Domoconnor/orange-corpus/README.markdown

# orange-corpus
 
To create a new version of final.md run this command in your cloned version:

`cat *.md  > final.md`

Make sure there isn't a file called final.md when you run that command otherwise it will endlessly loop

After that open up final.md in macdown and export it as an html file.
