Domoconnor/orange-corpus/11_Minutes.md

### Minutes

Below are the minutes taken for every meeting that we, personally had between us as a group. They are a rough summary of what decisions we chose to take and how we followed up on them in the weeks after.

Weekly Minutes (September 27th - 25th March 2016)

####27/9/2015
##### Members attendance
* Daniel Andrews
* Dominic O’Connor
* Jack McBride
* Matthew Aldridge

##### Main points
* Project begins.
* Meeting with supervisor, arranging a meeting with clients.
* Research into general hardware understanding.
* Research into general electronics understanding.

##### Work Achieved previous week
* Orange Street itself documented, photographs taken of popular outlets along the street and general overview.

####3/10/2015
##### Members attendance
* Daniel Andrews
* Dominic O’Connor
* Jack McBride
* Matthew Aldridge

##### Main points
* Research into sensor amplifier, this is required for our sensor to accurately measure noise.
* Reading Portigal Book, this is required to interview our clients in the best format possible.

##### Work Achieved previous week
* Circuit diagrams for amplifier and research completed.
* Research into hardware boards completed.

####10/10/2015
##### Members attendance
* Daniel Andrews
* Dominic O’Connor
* Jack McBride

##### Main points
* Working on sensor amplifier, have to calculate accurate values for use.
* Concluding on client meetings, taking notes from the important moments in the meeting.
* Sensors are required as expected, multiple of them will be used to gather data on sound.
* Starting to learn 3D print, will need case designs for components in the project. 
* Start researching potential solutions in system architecture to the problem.

##### Work Achieved previous week
* Client interviews completed, recorded and documented. 

####18/10/2015
##### Members attendance
* Daniel Andrews
* Dominic O’Connor
* Jack McBride
* Matthew Aldridge

##### Main points
* A Basic sensor has been created using the amplifier circuit, can now use this act as a sensor temporarily.
* Program needs to be written to sample sound from the current sensor.
* Researching sound waves and understanding of sampling, need a better technical understanding of sampling sound waves and sound in general.
* Researching into potential networking solutions, we need a way of transferring this data from the sensor to the website.
* Researching into hardware boards, Arduinos, MBEDs, any particular board that could be used to handle the sensors requirements.

##### Work Achieved previous week
* Microphone amplifier built, testing begins this week.
* System architecture researched, deciding to use - sensor to hub to webserver.
* 3D print attempts, not successful for the board - but very close.
* Contacted council and received advice for legal standing on our project.

####25/10/2015
##### Members attendance
* Dominic O’Connor
* Jack McBride
* Matthew Aldridge

##### Main points
* Using the written program for sampling data from the sensor, taking this sampled data and working out how to gather the values we need in order to demonstrate a sound level.
* Using the FRDM K64F as a guide - 3D printing a case for this board.
* Decision to use the XBee as our networking module, offers great customisation and low power cost.

##### Work Achieved previous week
* Created program to sample sound waves, tested on Arduino and FRDM-K64F boards.
* First successful 3D printed case designed

####2/11/2015
##### Members attendance
* Daniel Andrews
* Dominic O’Connor
* Jack McBride
* Matthew Aldridge

##### Main points
* Started using Github to handle different elements of the project code base.
* Started getting XBees S2 talking to each other, sending dummy data between two modules.
* Began discussing how often we wish to sample data, how many samples to take and the accuracy of our data. 
* Researching into very low boards to act in place of the sensor.

##### Work Achieved previous week
* Displaying sound a period of time, research needed on decibels.
* Plenty of test data stored from the initial testing of sensor.
* Research completed on networking solutions.
* Website API implemented, sensor iteration 4 started by Dominic.

####9/11/2015
##### Members attendance
* Daniel Andrews
* Jack McBride
* Matthew Aldridge

##### Main points
* Discussed the potential of using the FRDM-K64F as a Hub as we are familiar with it.
* Looking into XBees and their configurability, discussing whether encryption or the alike is necessary.
* Researching into converting sound values into decibel levels.

##### Work Achieved previous week
* Using XBees to communicate over serial on FRDM-K64F with MBED application shields with AT mode.
* Concluded to sample data once a minute for 3 seconds, 60 times an hour.
* Multiple case designs printed.

####16/11/2015
##### Members attendance
* Daniel Andrews
* Dominic O’Connor
* Jack McBride
* Matthew Aldridge

##### Main points
* Still working with XBees, looking into setting up multiple on a network with a mesh topology as opposed to point to point.
* Discussed the battery concerns, clients ideally want a rechargeable set of batteries. Looking into battery solutions.
* Sketching visualisation ideas.  
* Decided on using the Rocket scream board for the sensor, but going to use Arduino Uno for the time being.

##### Work Achieved previous week
* Decided to use the FRDM-K64F as the Hub
* Successfully found a way to convert raw values from the sensor into decibels.
* Looked into configuring XBee modules.
* Sensor implemented clock for timestamping.

####23/11/2015
##### Members attendance
* Daniel Andrews
* Dominic O’Connor
* Matthew Aldridge

##### Main points
* Attempting to get an Arduino board communicating to an XBee, wiring the module up ourselves as it’s likely we’ll use an Arduino board.
* After showing 5 sketches produced from each other, we concepted some form of clock that displays noise levels.
* Researching into different solutions for a Hub instead of FRDM-K64F. 
* Prototype of sensor is going to be placed in client's house over Christmas break.
* Prototype will use local SD card instead of network due to power restrictions with the board being used.

##### Work Achieved previous week
* Researched batteries, worked out calculations required for the sensor in its current state to function over Christmas.
* Concepted the idea of a ‘clock’ from 5 sketches idea.
* Rocket Scream ordered, waiting for arrival.

####30/11/2015
##### Members attendance
* Daniel Andrews
* Dominic O’Connor
* Jack McBride
* Matthew Aldridge

##### Main points
* Mapping locations for sensors, where are we likely place them - what sort of problems does this raise?
* Concepting case designs for the Arduino Uno.
* Researching components for a clock like device.
* Working towards placing a sensor in client's house before Christmas.

##### Work Achieved previous week
* Arduino board communicating with XBee and an FRDM-K64F over serial using AT mode.
* Sensor SD card implemented, data will be stored locally for the project due

####7/12/2015
##### Members attendance
* Daniel Andrews
* Dominic O’Connor
* Jack McBride
* Matthew Aldridge

##### Main points
* Going to use AT mode for XBee for Hub and sensor, simpler to set up and then focus on API mode of XBee. 
Research into XBee settings, API mode.
* Clock components decided, visualising components and how to use them. Going to use 24 LEDS on the clock for 24 hours.

##### Work Achieved previous week
* Case for sensor printed.

####14/12/2015
##### Members attendance
* Daniel Andrews
* Dominic O’Connor
* Jack McBride
* Matthew Aldridge

##### Main points
* Clock testing and programming, deciding what colours to use, frequency of them.
* Case design tested, researching into weatherproofing the case.
* Raspberry Pi decided for the Hub.
* Going to use a large battery to power sensor for 8 days roughly.
* Decided to sample once a minute and average to use as a representation of that minute.

##### Work Achieved previous week
* Components arrived for clock, connected together and testing 
* Testing on sensor.

####21/12/2015
##### Members attendance
* Daniel Andrews
* Jack McBride
* Matthew Aldridge

##### Main points
* Final meeting before Christmas break, sensor has been placed in Client's house on Orange Street. 
* Rocket scream board arrived, testing with rechargeable batteries is next step
* AT Networking finalised.

##### Work Achieved previous week
* Sensor installed in client’s house
* End of term 1.

####20/1/2016
##### Members attendance
* Daniel Andrews
* Dominic O’Connor
* Jack McBride
* Matthew Aldridge

##### Main points
* First meeting since end of Christmas break, sensor has been collected and data returned for evaluation.
* From result it is hard to determine accuracy of noise, sampling needs to be more accurate
* Increasing sampling rate to 3 times a minute.
* Work commencing on creating the Hub, and arranging networked solutions.

##### Work Achieved previous week
* Over Christmas, research on Rocket Scream, XBee, Clock and Case design.

####27/1/2016
##### Members attendance
* Daniel Andrews
* Dominic O’Connor
* Matthew Aldridge

##### Main points
* Clock case design prototyping started.
* Raspberry Pi Model B+ acquired, programming beginning in Python with Jessie Lite as the Operating System.
* Investigating how to visualise data on the website.
* Order requested for components to build more sensors.
* Sampling rate is now much more accurate.

##### Work Achieved previous week
* Raspberry Pi initialisation, setting up and configuring to work with a XBee.
* Rocket Scream replaced Arduino Uno as sensor board.
* Sample rate modified to be more accurate.
* Initial test of Clock with 24 LEDs, potentially using 60 LEDs.

####3/2/2016
##### Members attendance
* Daniel Andrews
* Dominic O’Connor
* Jack McBride
* Matthew Aldridge

##### Main points
* Programming the RocketScream, research into power usage with the board (disabling/enabling features).
* Researching sleep mode configuration on XBee modules.
* Case design for Hub started.
* Hub to backup data if network fails.

##### Work Achieved previous week
* Pi configured to work as coordinator, work commencing to program.
* Initial version of Hub AT model finished.
* Case research into waterproofing, protection against rain in particular.

####10/2/2016
##### Members attendance
* Dominic O’Connor
* Jack McBride
* Matthew Aldridge

##### Main points
* Finished hub, need to test with all components under different circumstances.
* Sensor finished, accuracy lacking - looking into solutions.
* Case design for clock on-going.
* Colour sensitive users for clock.

##### Work Achieved previous week
* Case design for clock finished along with initial sensor.
* Initial Clock program finished, interfacing with Hub is next step.

####17/2/2016
##### Members attendance
* Daniel Andrews
* Dominic O’Connor
* Jack McBride
* Matthew Aldridge

##### Main points
* Light intensity as opposed to different colours for users of colour blind nature.
* New sensor prototype almost finished, solution to accuracy is a 16bit ADC.
* New case design for sensor, directional microphone.

##### Work Achieved previous week
* Website configured to communicate with Hub on GET and POST.
* Hub tests all successful.
* Clock case prototyped.

####24/2/2016
##### Members attendance
* Daniel Andrews
* Dominic O’Connor
* Jack McBride
* Matthew Aldridge

##### Main points
* Testing entire system in the ‘wild’, sensor outside, clock on the side and Hub routing traffic.
* If goes to plan, place in Client's house during this week.
* Case finished for sensor, case for clock next.
* Current networking is AT mode.
* Live visualization being worked on.

##### Work Achieved previous week
* Decision to work with API mode has been made.
* Sensor now uses 16ADC as well to boost accuracy of raw values.
* Clock features colour alternatives for those who suffer from colour blindness.

####31/2/2016
##### Members attendance
* Daniel Andrews
* Dominic O’Connor
* Jack McBride
* Matthew Aldridge

##### Main points
* Designing initial poster for project fair.
* Programming API mode for network.
* Design for clock case finished. Need a way to diffuse light.

##### Work Achieved previous week
* System tested in our own homes, it even snowed - perfect for testing the sensor.
* Live visualisation completed, working on preparing the project for live use.

####7/3/2016
##### Members attendance
* Daniel Andrews
* Dominic O’Connor
* Jack McBride

##### Main points
* Placing system in clients home.
* Planning on testing website with users.
* Hub API mode finished.

##### Work Achieved previous week
* Poster concepted and designed.
* Clock case finished and light diffused.
* Hub API mode finished.

####14/3/2016
##### Members attendance
* Daniel Andrews
* Dominic O’Connor
* Jack McBride
* Matthew Aldridge

##### Main points
* Building of a dummy sensor working with API mode to demonstrate capabilities.
* Visualisation of data finished.
* Clock case finished.
* Plans for poster to test the clock and demonstrate our visualisation.

##### Work Achieved previous week
* Poster concepted and designed.
* Clock case finished and light diffused.
* Hub API mode finished.

####18/3/2016
##### Members attendance
* Daniel Andrews
* Dominic O’Connor
* Jack McBride
* Matthew Aldridge

##### Main points
* Use clock to demonstrate noise levels and visualisation.
* Laptops and tablets for visualising website.
* Dummy sensor to demonstrate range and error correction.
* Hand out flyers on the project.

##### Work Achieved previous week
* Poster concepted and designed.
* Clock case finished and light diffused.
* Hub API mode finished.

####25/3/2016
##### Members attendance
* Daniel Andrews
* Dominic O’Connor
* Jack McBride
* Matthew Aldridge

##### Main points
* Formating corpus and technical report for project.

##### Work Achieved previous week
* Dummy sensor was a success.
* Live visualisation was a success.
* Sensor has survived for 2 weeks in the wild, including conditions.
* Clock updating correctly.
* Won the poster fair. 
* We managed to get rid of all our flyers.
