Domoconnor/orange-corpus/meeting_two/Quotes from Seb.docx

# Quotes From Seb

“The girl who’s really complaining, she’s in the back room and she’s complaining a lot about the bass”

“Bass can be more intrusive than the actual noise”

“There’s always been an issue whether it’s front or back, people coming down the street, people coming out for cigarettes”

“Without having someone record it you don’t know whether it is actually within the parameters [set by the council]”

“[regarding a camera] Along with the [sound] monitoring equipment it would actually show where people are coming from and gathering”

“I’ve always kind of thought it would be good to get cctv up there or some sort of visual monitoring equipment”

“That’s[Camera] be brilliant, I’m more than happy for you you to do that”

“It would be good if you could set up something front and back and have two lots [of readings]”

“I’m quite pleased to see you’re looking at including a camera as well”
