Domoconnor/orange-corpus/12_Sketches.md

##Sketches

To generate and combine ideas for our forms of data visualisation, we individually produced sketches. These sketches consisted of different formats of visualisation; ranging from the more technical approach of graphs and charts, to ambient forms of colour systems and "heatmaps".  

###Iteration 1

####Five-Sketches-or-Else Method

Our initial sketching phase, the **"5 sketches or else"** method, involved us each individually producing 5 different sketches of our proposed data visualisation. This was to be done in isolation of one another, preventing individual ideas from clashing with the opinions of others, and to promote unique designs amongst group members. 

We set out to design easy, straight forward ways to show data that our sensors had gathered. This premise inspired us to produce simple designs which weren't over complicated, but also ones that weren't limited by specific requirements. This allowed us to express some creative freedom in the process, and produce some interesting designs. 

**Here are our outcomes of the Five-Sketches-or-Else Method:** 

These initial sketches were drawn in pencil, and explored an open ended approach to data visualisation. They were comprised of several unique ideas; varying from typical graph formats, to looking at specific formatting for devices and tablets. 

sketch 2

	Sketch 1 - Sensor visualisation. This design focuses on highlighting the location that was most noisy. This was based upon the position of the dot, providing coverage over the course of a day. 
	
sketch 1
	
	Sketch 2 - Scatter graph sensor visualisation. This provides a more technical overview, plotting data of specific volume values for each sensor.

sketch 3

	Sketch 3 - Unique approach to graphing noise volume against time.
 
sketch 4

	Sketch 4 - 3D graph view. 

sketch 5

	Sketch 5 - Data visualisation on iOS devices.

<br>

From these sketches onwards, more of an emphasis to colour visualisation is made, drawing inspiration from colour systems to convey data. 

sketch 6
	
	Sketch 6 - Simple daily bar chart view

sketch 7

	Sketch 7 - Clock display. This is a more novel approach to data visualisation, and uses a clock to plot sound averages as segments. 

sketch 8

	Sketch 8 - Monthly sound average view. 

sketch 9

	Sketch 9 - Side by side view of critical noise periods against normal periods.

sketch 10

	Sketch 10 - Interchangeable bar chart and line graph view. Offers two different views of data, which can be altered according to user preference.

sketch 11

	Sketch 11 - Line graph plot of average noise, current noise, and previous month's average.

sketch 12

	Sketch 12 - Histogram view of normal sound levels vs current sound levels.

sketch 13

	Sketch 13 - Heatmap view - another novel form of visualisation, this is a map of Orange street which is coloured according to noise "hotspots". Used to provide granularity between quieter and noisier areas, and pinpoint disturbances.

sketch 14

	Sketch 14 - Line graph and colour coded display - intended to establish sound "thresholds", which clearly indicate to the user when the noise level has crossed a certain boundary. 

sketch 15

	Sketch 15 - Calendar view - A combination of the clock view with a daily/weekly/monthly comparison chart. 
	
sketch 16

	Sketch 16 - Chart and graph view - this is a crossover design featuring a min and max for sound readings, and a date layout in a chart. 

sketch 17

	Sketch 17 - Sensor scatter graph - very similar to one of the other concepts, this design showed how there were common elements between our work even though they were completed in isolation of one another. 

sketch 18

	Sketch 18 - Clock view - this sketch reinforces the time element of the monitoring, and incorporates ambient colour. 

sketch 19

	Sketch 19 - Threshold bar chart - a combination of a bar chart with intervals representing sound thresholds. It features added labels to associate the coloured threshold with a corresponding noise range, e.g. street, nighttime.

sketch 20

	Sketch 20 - Coloured chart - this combines a less technical overview of data; presenting the high, low, and average decibels to the user. It also uses a colour system to direct the user towards louder time periods, by using more intense colours. 

<br>

####Outcome of Iteration
During this iteration, we began to develop our data visualisation platform. We considered individual approaches to visualising sound data; incorporating trusted forms of display such as graphs, diagrams, and chart, as well as experimenting with new, less common ideas. As a result of these experiments, we approached our data visualisation creatively, creating a wide range of possibilities for what we finally provide to our client. 

After this iteration, we have set up a platform to build upon for our data visualisation. We can now look into combining ideas to come up with more dynamic concepts. 

####Iteration 2

####Combined Sketches 
Once we had each individually developed five sketches, we shared them, and collaborated ideas behind our chosen data formats. This lead to crossovers in ideas, and common themes and designs behind ideas were identified. 

In this phase, we focused on combining our ideas and extending the functionality of our existing designs. As a result, our sketches became more specific, and we began to consider how realistically they could be implemented. 

The focus here, was placed upon what forms of visualisation the client would find most useful. We held onto some of our novel ideas, such as **the clock**, and further developed them alongside other means. 

**Here are our outcomes of the Combined Sketches Method:**

combined sketch 1

	Combined sketch 1 - Histogram crossed with noise threshold.

combined sketch 2

	Combined sketch 2 - Graph and clock view - incorporates a clock view to display user, and shows the relative sound level at each time interval.

combined sketch 3

	Combined sketch 3 - Sensor and decibel level view - combines the ideas of having a sensor centric visualisation which pinpoints activity, and a decibel scaling system.

combined sketch 4

	Combined sketch 4 - Heatmap and graph visualisation - this sketch integrates the novel approach of the street heatmap with a line graph to reinforce the data.

combined sketch 5

	Combined sketch 5 - Threshold graph comparison - designed to give the user to ability to compare several different dates in terms of sound thresholds that were crossed. 

combined sketch 6

	Combined sketch 6 - Touch screen / tablet heatmap view. Adds the extra detail of a colour based averaging system to the heatmap, and implements it for a touchscreen device. 

combined sketch 7

	Combined sketch 7 - Graphical sensor comparison. This visualisation provides a time scale on the X axis, and the ability to add series from different sensors. 

combined sketch 8

	Combined sketch 8 - Sensor map view - incorporates a variable time system with a sensor map, where the user can view sensor activity according to their desired time parameters. 

combined sketch 9

	Combined sketch 9 - Coloured time chart - a colourful approach to visualisation, this sketch creates a coloured sound scaling system, and plots its as a grid. Useful for daily comparisons, and averaging sound activity over time in easily interpreted formats. 

####Outcome of Iteration
During our second iteration of sketching, we have developed upon our existing bank of data visualisation ideas, and been more conscious in our approach of realistic data formats. This iteration has featured a much more colour oriented approach; drawing more upon ambient visual aids to create signposting for the user. The fidelity of the designs has resultantly increased, and ideas have become more amalgamated together, and specific to the client's needs. 

A recurring theme for visualisation during this iteration has been time, and how our system can use it to generate comparable data. It is concluded that time plays a large role in our system; especially since one of the major requirements is to have comparable data between dates. 

###Iteration 3

####Balsamiq, and Interface Mockups

Before we implemented our front end visualisation, it was important to explore different layouts and styles, which could then be translated into code. To do this, we used the lightweight mockup tool, **Balsamiq**, the create several different design mockups. These mockups were intended to simulate our various data platforms, by visualising website and application layouts, and having charts and diagrams to show how our visualisation would work in these contexts. 

In these designs, we aimed to produce easily interpretable interfaces which focus purely on visualisation. We wanted to remove any other distractions from the user, and draw their attention to the main priority: their data. 

To do this, our designs are minimalistic, and implement easily graspable layouts and methods of navigation. There is opportunity to further develop upon these simplistic designs at later points, but these designs capture the essential details. 

**Here are the outcomes of our Balsamiq designs:**

Balsamiq sketch 1

	Balsamiq Sketch 1 - Main street view of Orange street. This is intended to be the main interface for the front end visualisation, where the user can add data widgets such as the "graph" and "calendar" to build the data they want to view. 

Balsamiq sketch 2

	Balsamiq Sketch 2 - Specific data view for sensors - the user can click or touch a sensor and access the data for that specific sensor. 

Balsamiq sketch 3

	Balsamiq Sketch 3 - Graph view - here the earlier graph sketches are represented on a website, featuring a date widget that the user can manipulate to return data from different time periods.

Balsamiq sketch 4

	Balsamiq Sketch 4 - Graph and calendar comparison widgets - having activated both the graph and calendar widgets. The user can compare two sets of data over different time periods, side by side. 

Balsamiq sketch 5

	Balsamiq Sketch 5 - Single graph and calendar widget - if the user wants to add different dates as series on a graph, this view meets their requirement. Extra data series can be added using the "Add data" button.

Balsamiq sketch 6

	Balsamiq Sketch 6 - Map and graph comparison widgets - If the user wants to view general sensor data and compare it to average hourly data, this view can be used. Also featured is the scaling icons, which the user can use to increase, or decrease the size of their widgets; depending upon what they want to see more. 

Balsamiq sketch 7

	Balsamiq Sketch 7 - 4 widget view - the complete package of data widgets, granting data continuity to the user across four separate platforms.

Balsamiq sketch 8

	Balsamiq Sketch 8 - Tablet/mobile view - if the user prefers using other platforms, this sketch demonstrates how the interface might scale depending upon the size it operates in. 

Balsamiq sketch 9
	
	Balsamiq Sketch 9 - Hub interface display - later in this stage, we considered visualisation for the hub, and how a diagnostics system could work. Since it is the centrepoint of the network, this could be used to display information to the user based on which devices are in range, and specific properties of them. 

####Outcome of Iteration
In our final iteration of sketching and mockups, we have successfully established  a set of design blueprints which can be used to drive our front end visualisation. These designs implement some of the key concepts seen in our earliest form of visualisation, and develops them in a high fidelity manner. This process has added a degree of realness and feasibility to our designs, by effectively filtering out the less reliable forms of visualisation, and drawing the user's attention to more quantitative aspects. These forms of data, implemented as graphs and charts, display sound data in a technical way, and can be used in conjunction of one another to build a holistic description of the sound levels. 

Overall, we felt that the sketching process helped us formulate and refine our ideas, and that over our sequence of iterations there have been continual improvements. Each iteration has marked a significant development in our ideas, as they have become more specific and considerate of the user over time.
