Domoconnor/orange-corpus/Images/Case Images/Case_3.jpg

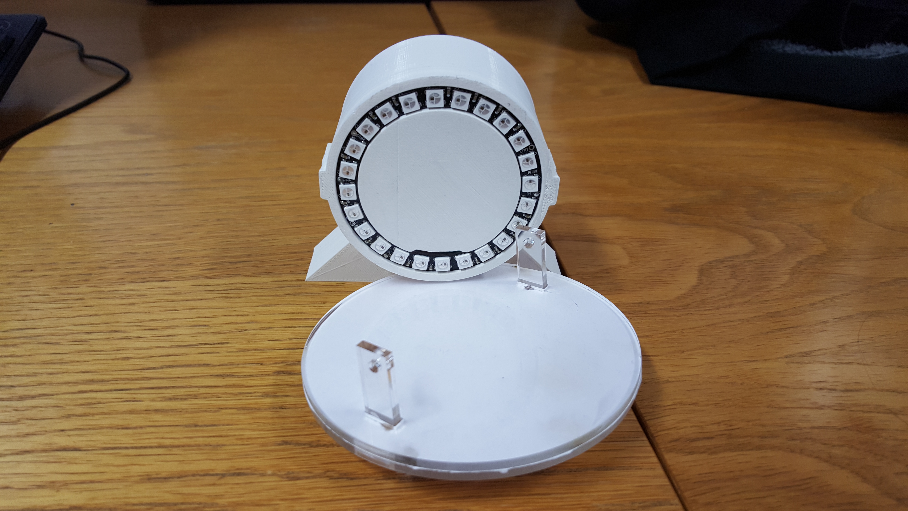
Images/Case Images/Case_3.jpg
