Domoconnor/orange-corpus/Images/Case Images/Case_4.jpg

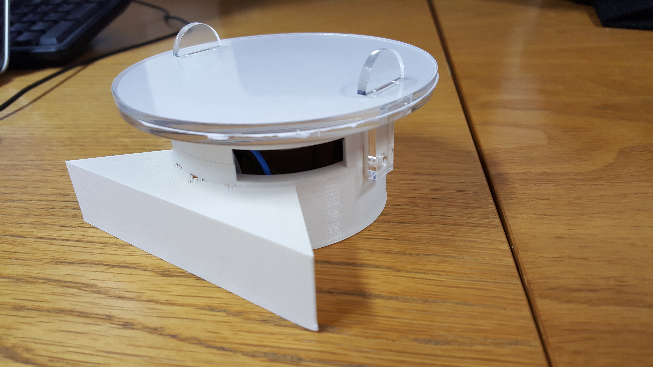
Images/Case Images/Case_4.jpg
