Domoconnor/orange-corpus/Images/Case Images/Case_5.jpg

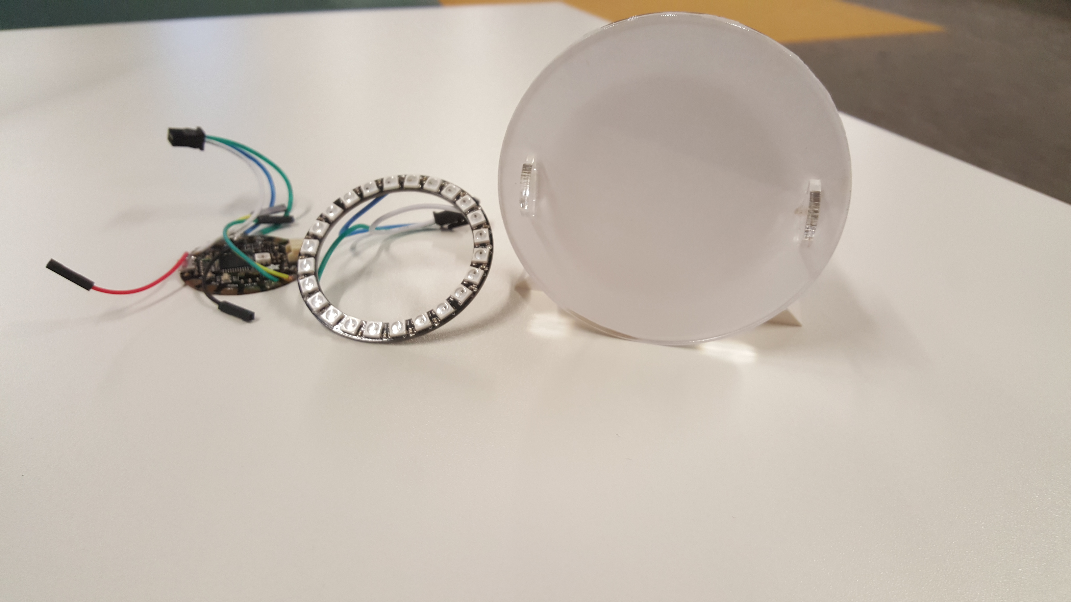
Images/Case Images/Case_5.jpg
