Domoconnor/orange-corpus/Images/Case Images/Case_6.jpg

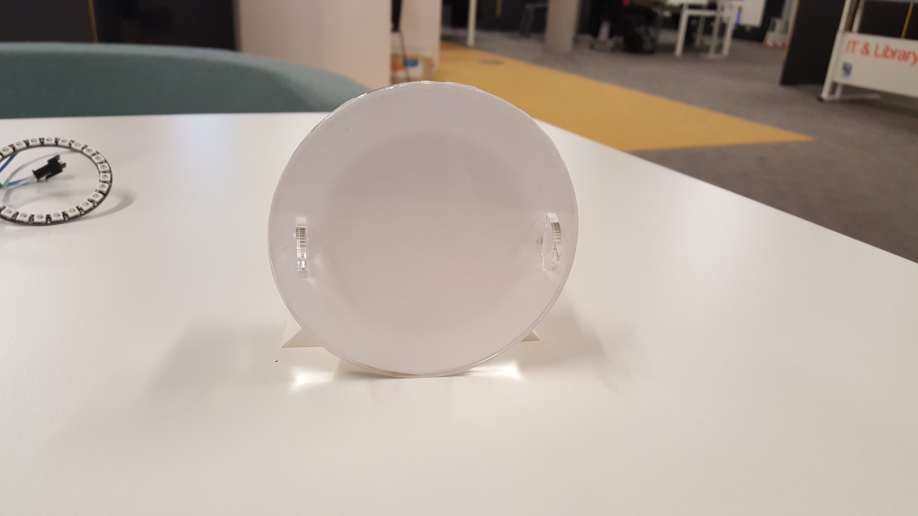
Images/Case Images/Case_6.jpg
