Domoconnor/orange-corpus/Images/case/clock_case.png

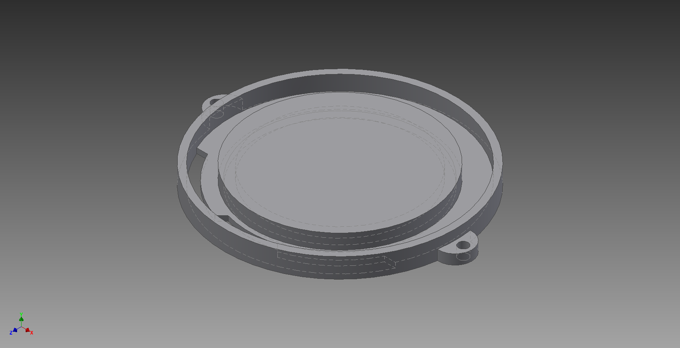
Images/case/clock_case.png
