Domoconnor/orange-corpus/Images/Clock Images/clock_comparison.png

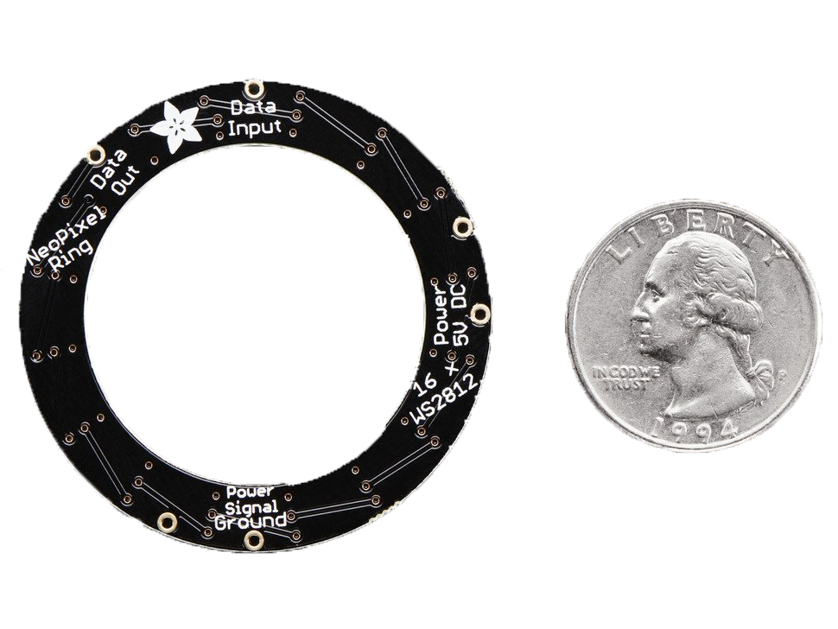
Images/Clock Images/clock_comparison.png
