Domoconnor/orange-corpus/Images/Clock Images/clock_models copy.png

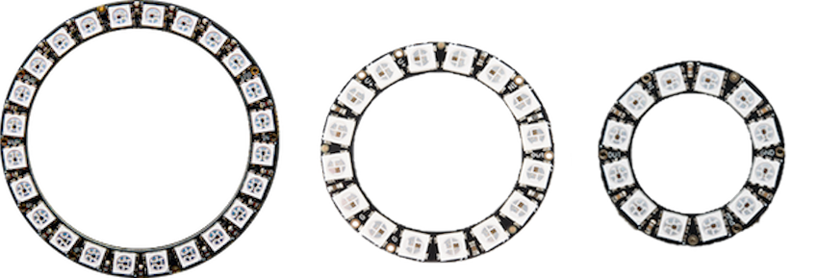
Images/Clock Images/clock_models copy.png
