Domoconnor/orange-corpus/Images/Clock Images/IMAGE_1.jpeg

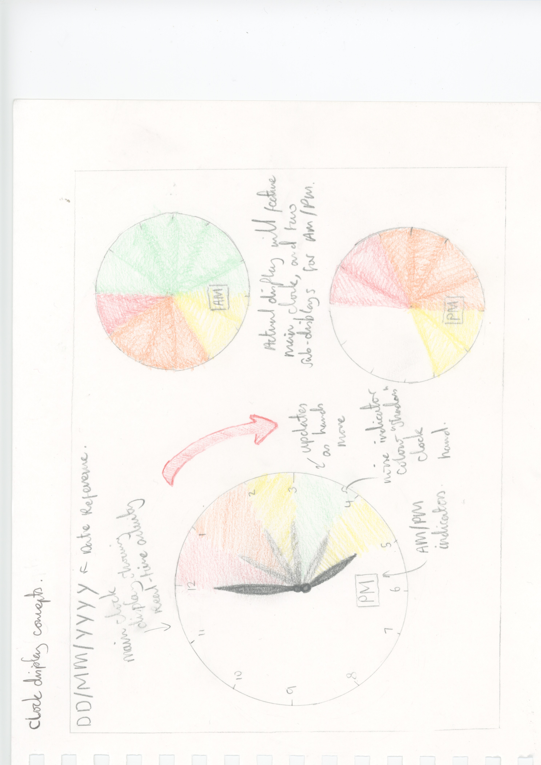
Images/Clock Images/IMAGE_1.jpeg
