Domoconnor/orange-corpus/Images/Clock Images/IMAGE_2.jpeg

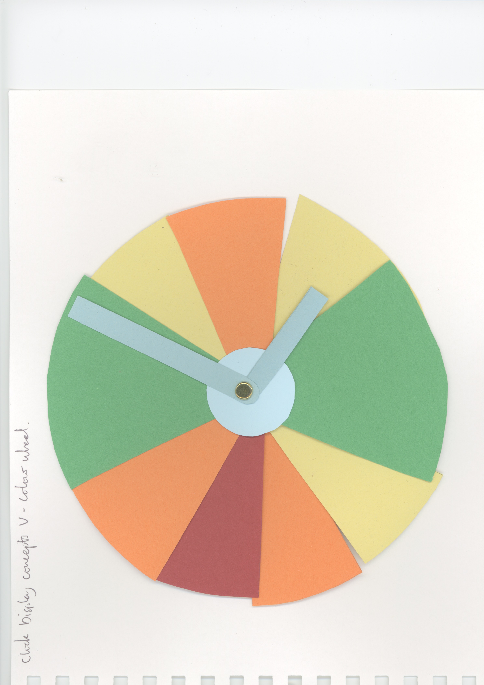
Images/Clock Images/IMAGE_2.jpeg
