Domoconnor/orange-corpus/Images/Clock Images/IMAGE_3.jpeg

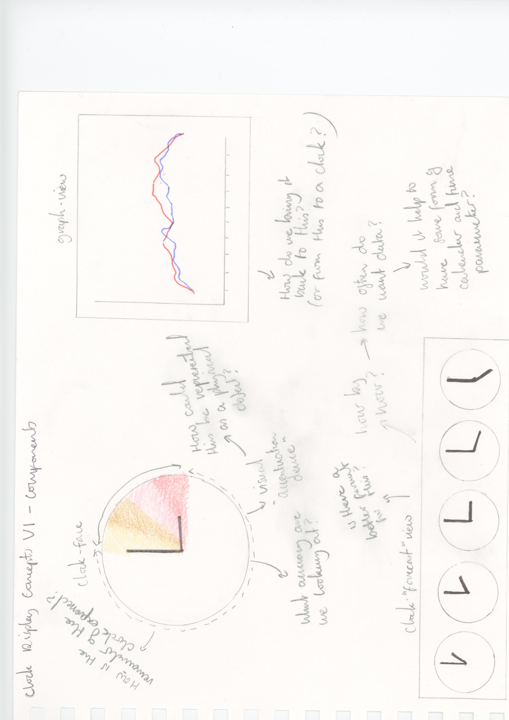
Images/Clock Images/IMAGE_3.jpeg
