Domoconnor/orange-corpus/Images/Clock Images/IMAGE_7.png

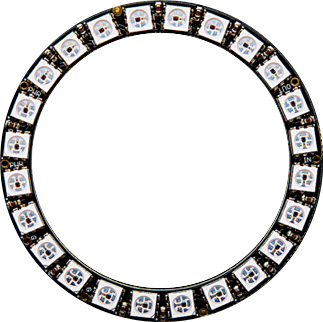
Images/Clock Images/IMAGE_7.png
