Domoconnor/orange-corpus/Images/Clock Images/IMAGE_14.jpg

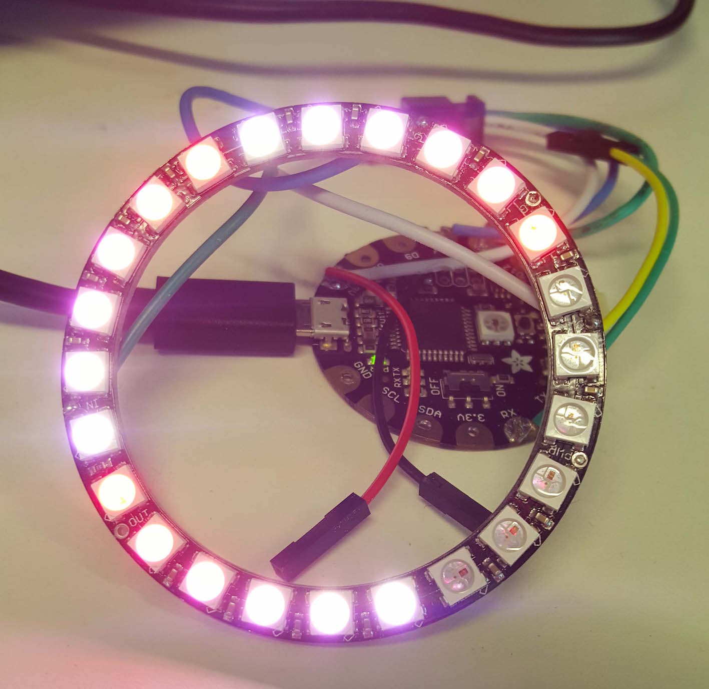
Images/Clock Images/IMAGE_14.jpg
