Domoconnor/orange-corpus/Images/Clock Images/IMAGE_32.jpeg

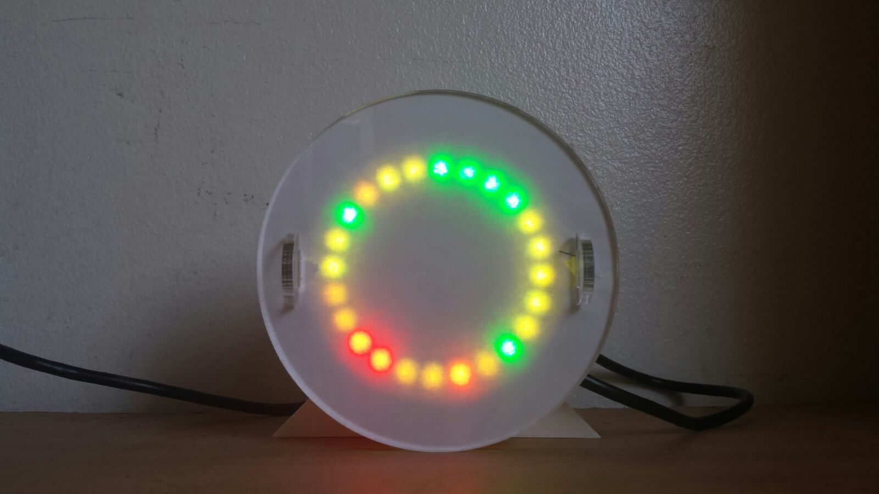
Images/Clock Images/IMAGE_32.jpeg
