Domoconnor/orange-corpus/Images/Clock Images/IMAGE_33.jpeg

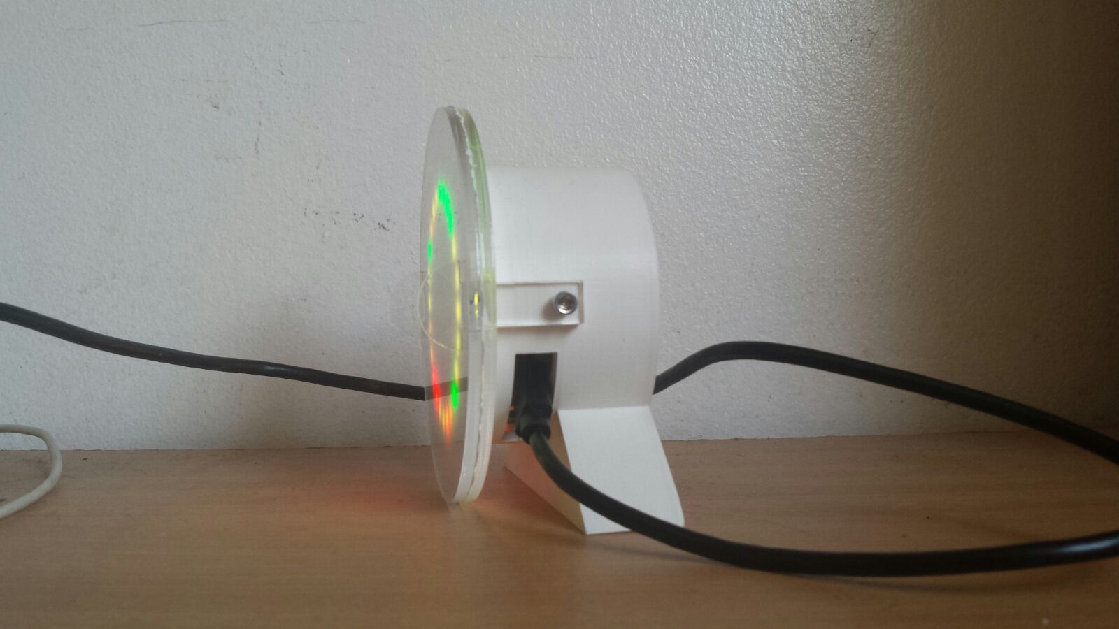
Images/Clock Images/IMAGE_33.jpeg
