Domoconnor/orange-corpus/Images/Clock Images/Screen Shot 2016-03-27 at 13.51.13.png

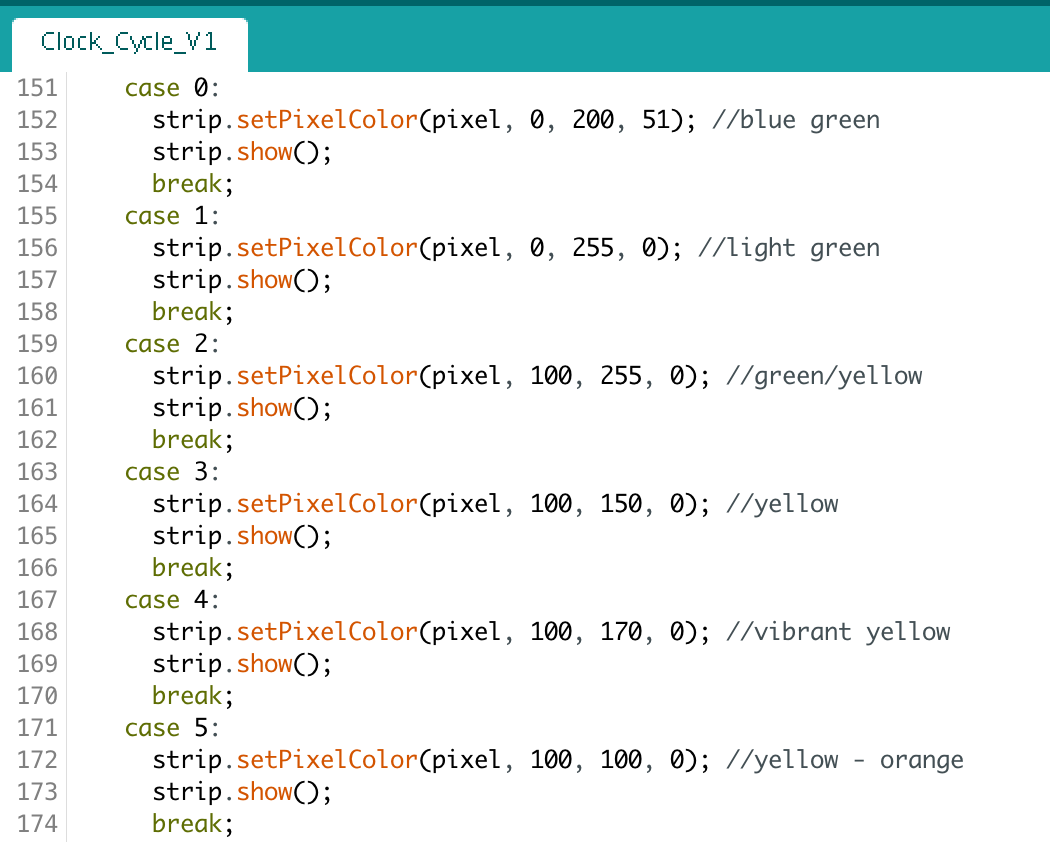
Images/Clock Images/Screen Shot 2016-03-27 at 13.51.13.png
