Domoconnor/orange-corpus/Images/Clock Images/Screen Shot 2016-03-27 at 14.06.29.png

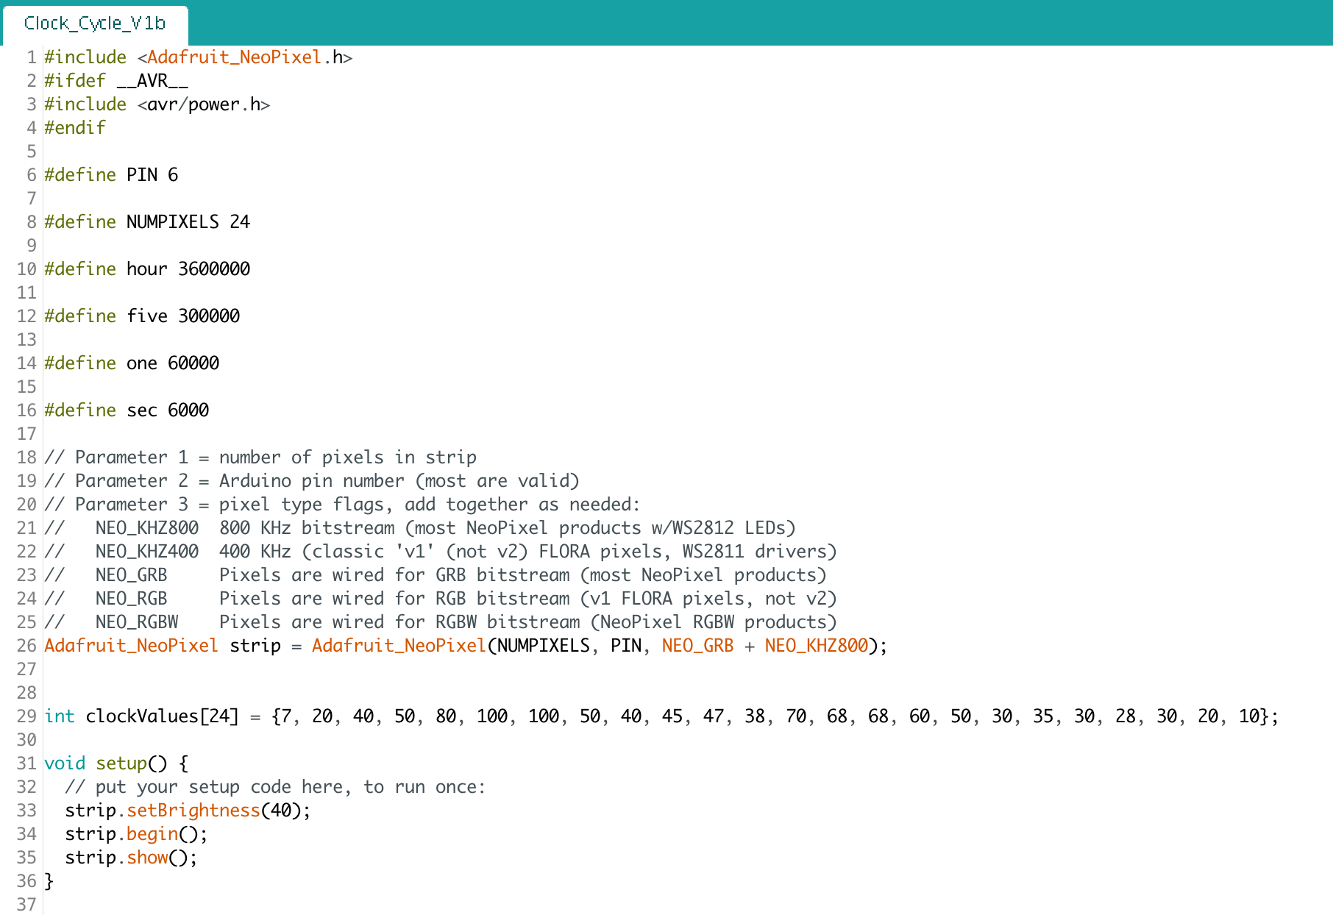
Images/Clock Images/Screen Shot 2016-03-27 at 14.06.29.png
