Domoconnor/orange-corpus/Images/Clock Images/Screen Shot 2016-03-29 at 10.18.08.png

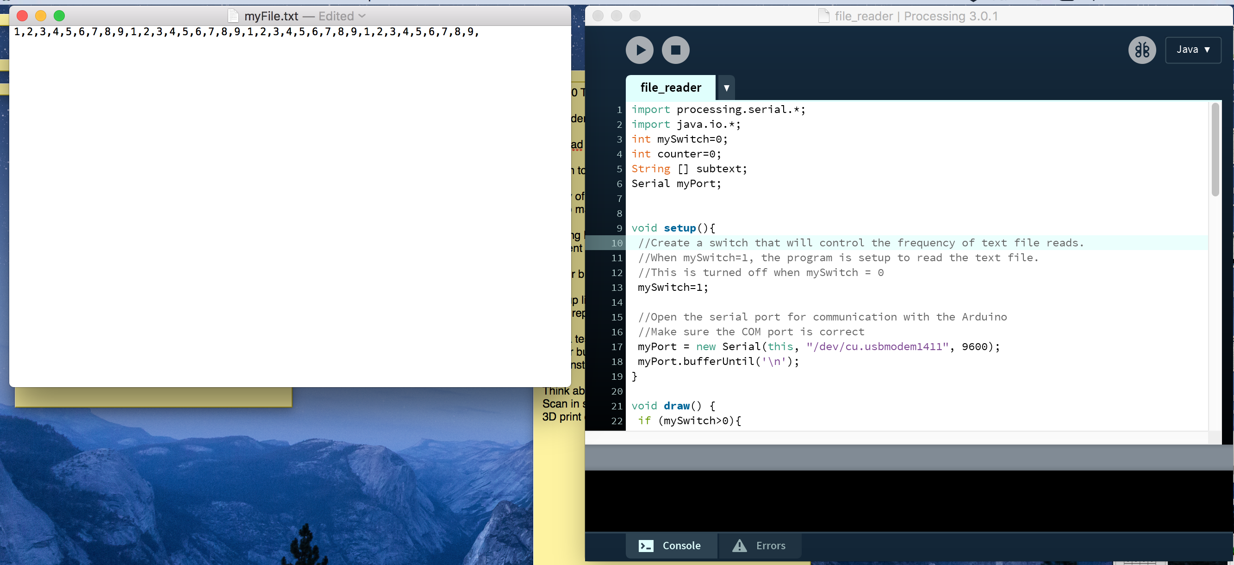
Images/Clock Images/Screen Shot 2016-03-29 at 10.18.08.png
