Domoconnor/orange-corpus/Images/Hub/IMAGE8.jpg

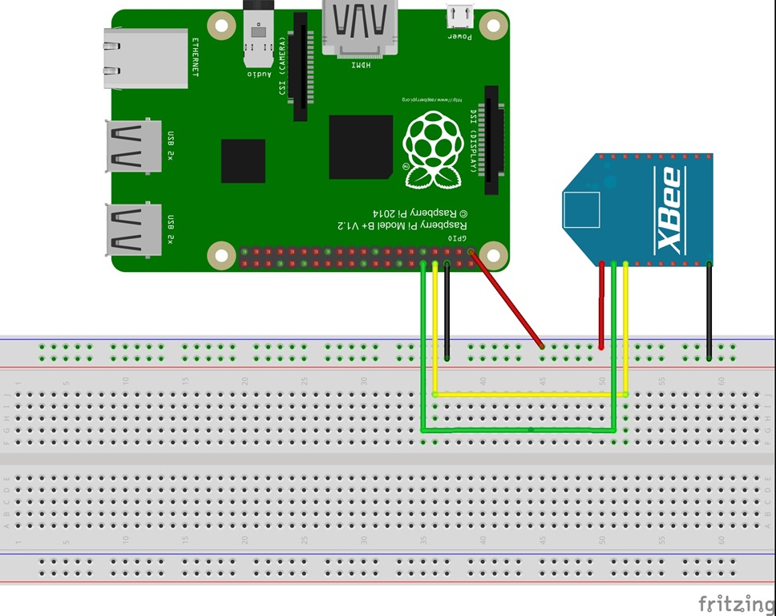
Images/Hub/IMAGE8.jpg
