Domoconnor/orange-corpus/Images/Networking/IMAGE3.PNG

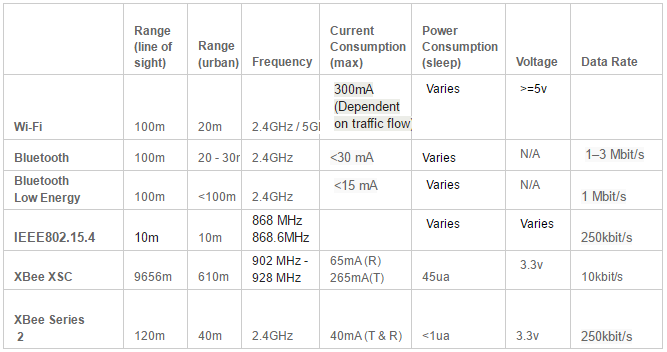
Images/Networking/IMAGE3.PNG
