Domoconnor/orange-corpus/Images/Networking/IMAGE3v2.PNG

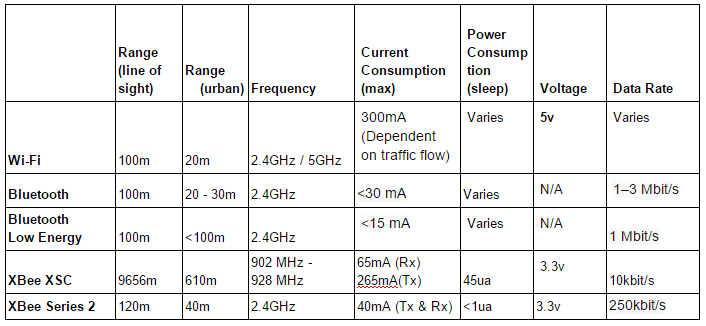
Images/Networking/IMAGE3v2.PNG
