Domoconnor/orange-corpus/Images/Networking/IMAGE7.PNG

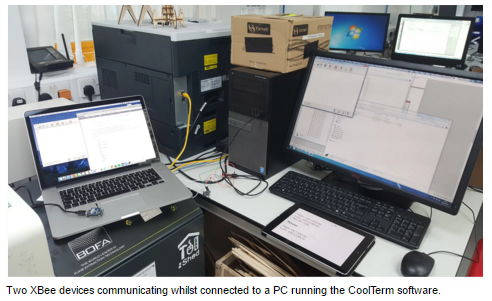
Images/Networking/IMAGE7.PNG
