Domoconnor/orange-corpus/Images/Networking/IMAGE8.PNG

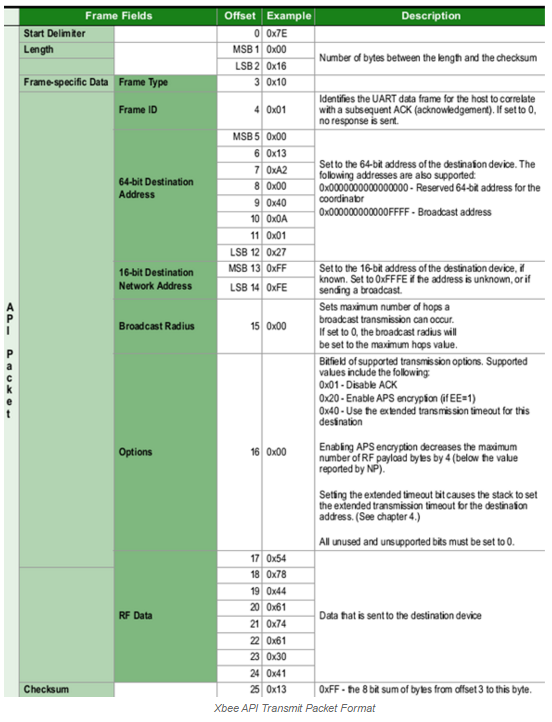
Images/Networking/IMAGE8.PNG
