Domoconnor/orange-corpus/Images/Networking/IMAGE9.PNG

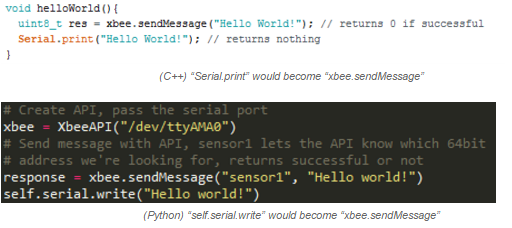
Images/Networking/IMAGE9.PNG
