Domoconnor/orange-corpus/Images/sensor/IMAGE7.PNG

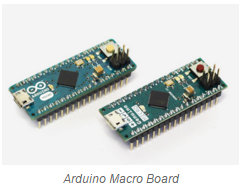
Images/sensor/IMAGE7.PNG
