Domoconnor/orange-corpus/Images/Sketch Images/Jack_11.png

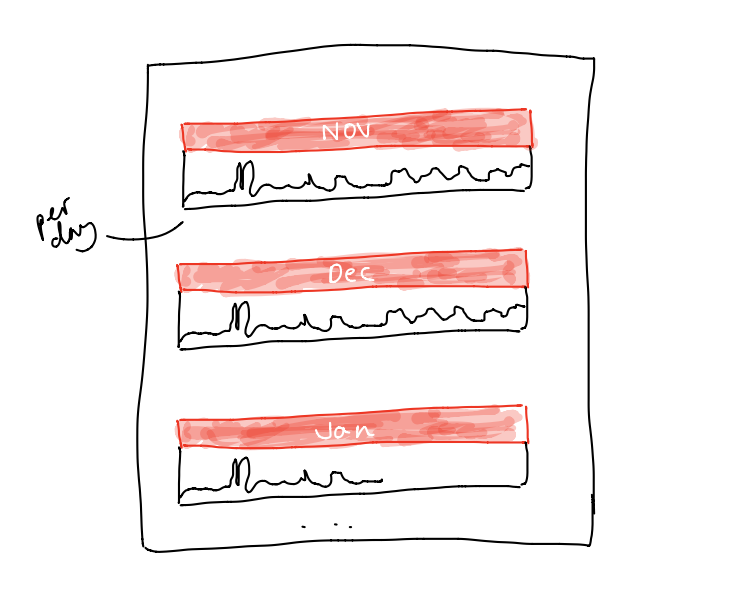
Images/Sketch Images/Jack_11.png
