Domoconnor/orange-corpus/visualisation/Dan/Idea 1 - Line Graph/1.png

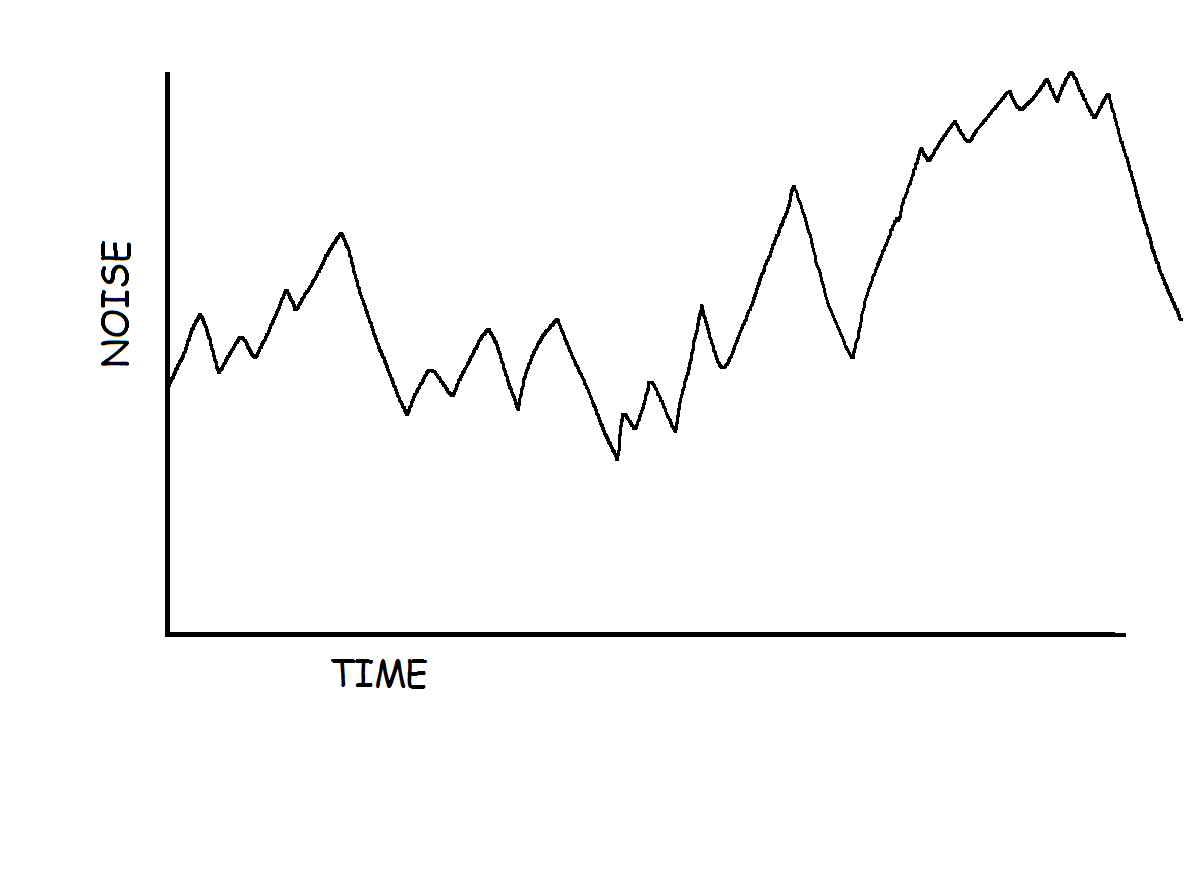
visualisation/Dan/Idea 1 - Line Graph/1.png
