Domoconnor/orange-corpus/visualisation/Dan/Idea 1 - Line Graph/2.png

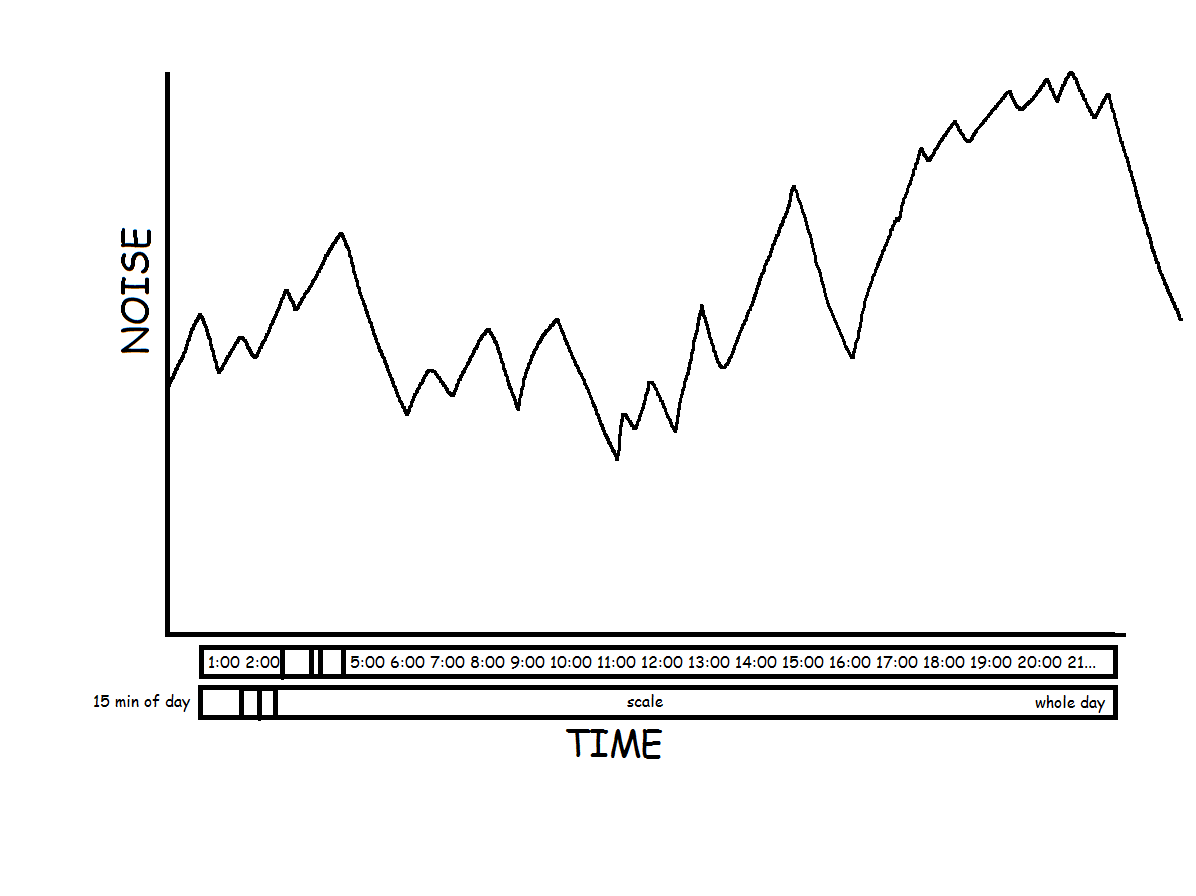
visualisation/Dan/Idea 1 - Line Graph/2.png
