Domoconnor/orange-corpus/visualisation/Dan/Idea 1 - Line Graph/3.png

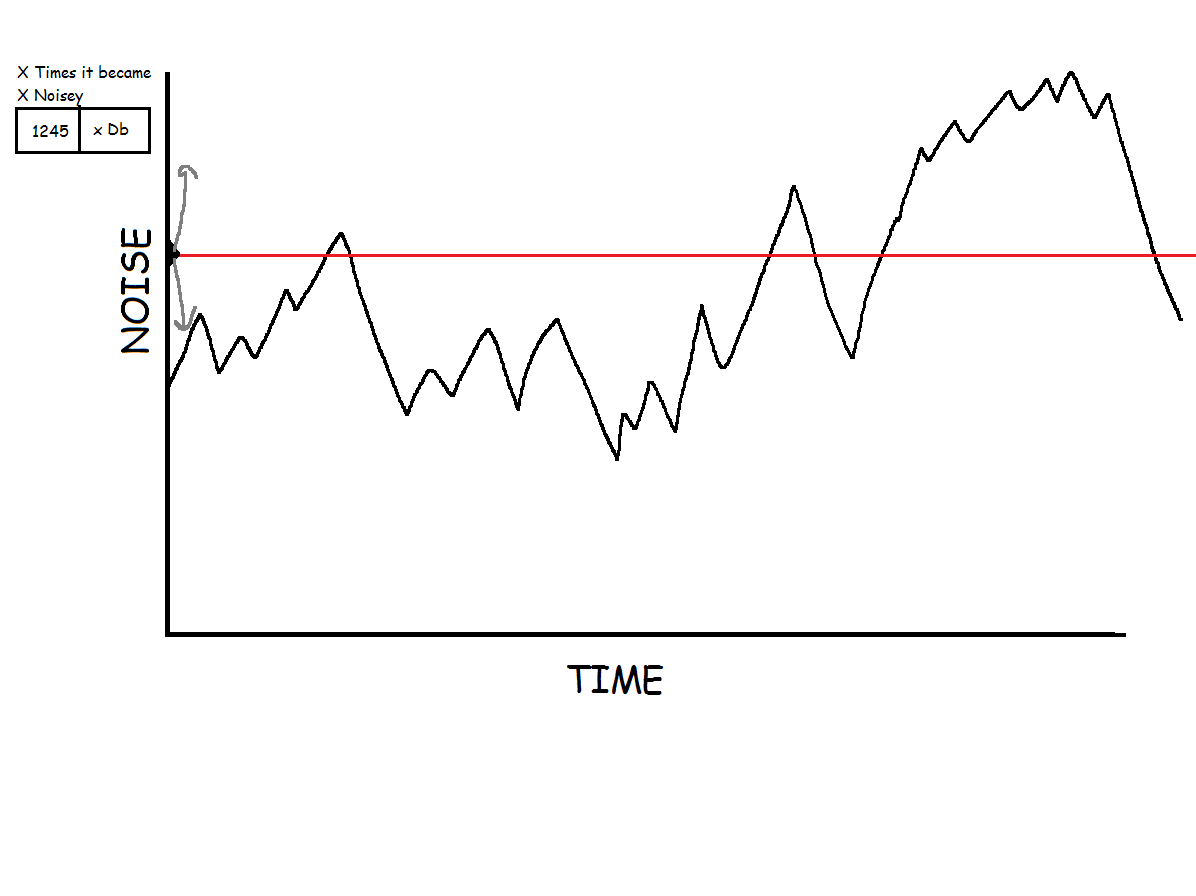
visualisation/Dan/Idea 1 - Line Graph/3.png
