Domoconnor/orange-corpus/visualisation/Dan/Idea 1 - Line Graph/4.png

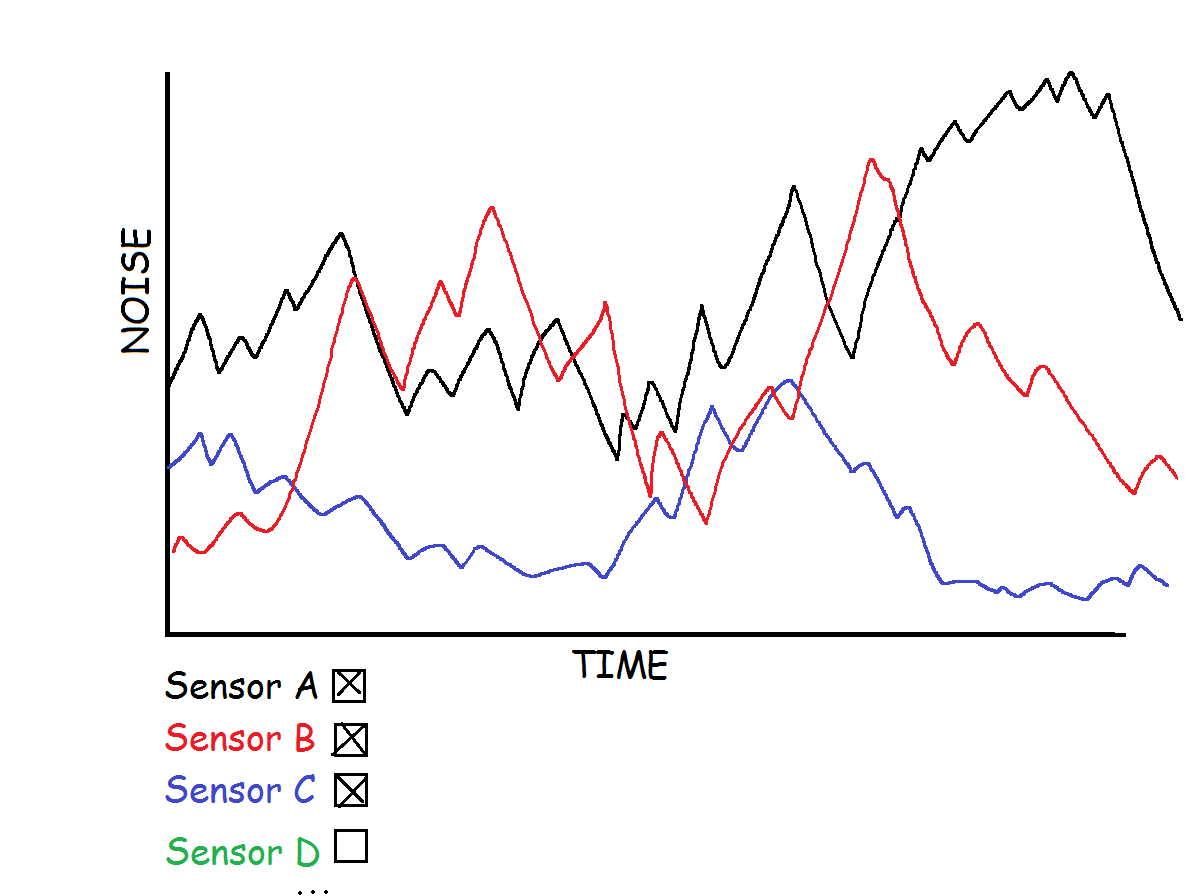
visualisation/Dan/Idea 1 - Line Graph/4.png
