Domoconnor/orange-corpus/visualisation/Dan/Idea 2 - Calender/1.png

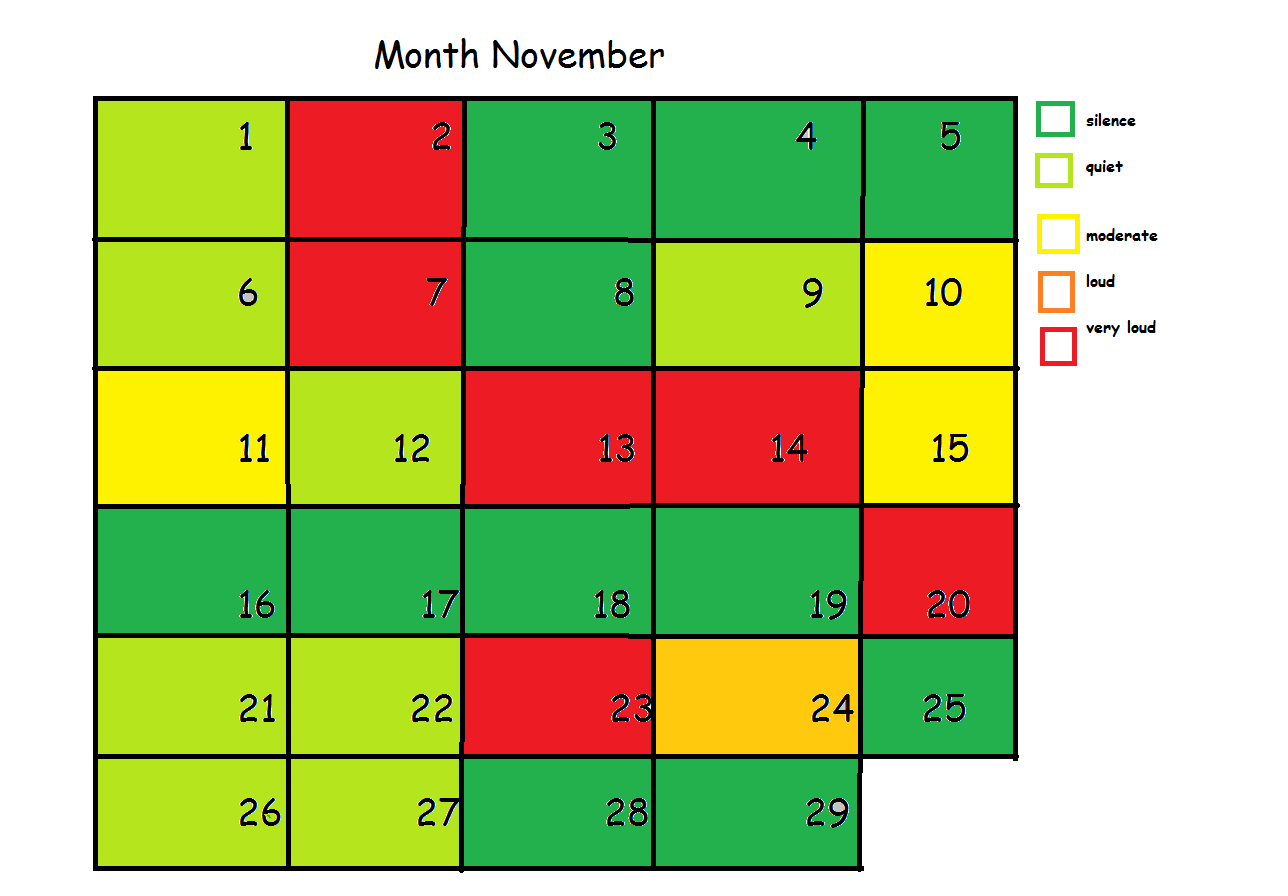
visualisation/Dan/Idea 2 - Calender/1.png
