Domoconnor/orange-corpus/visualisation/Dan/Idea 2 - Calender/2.png

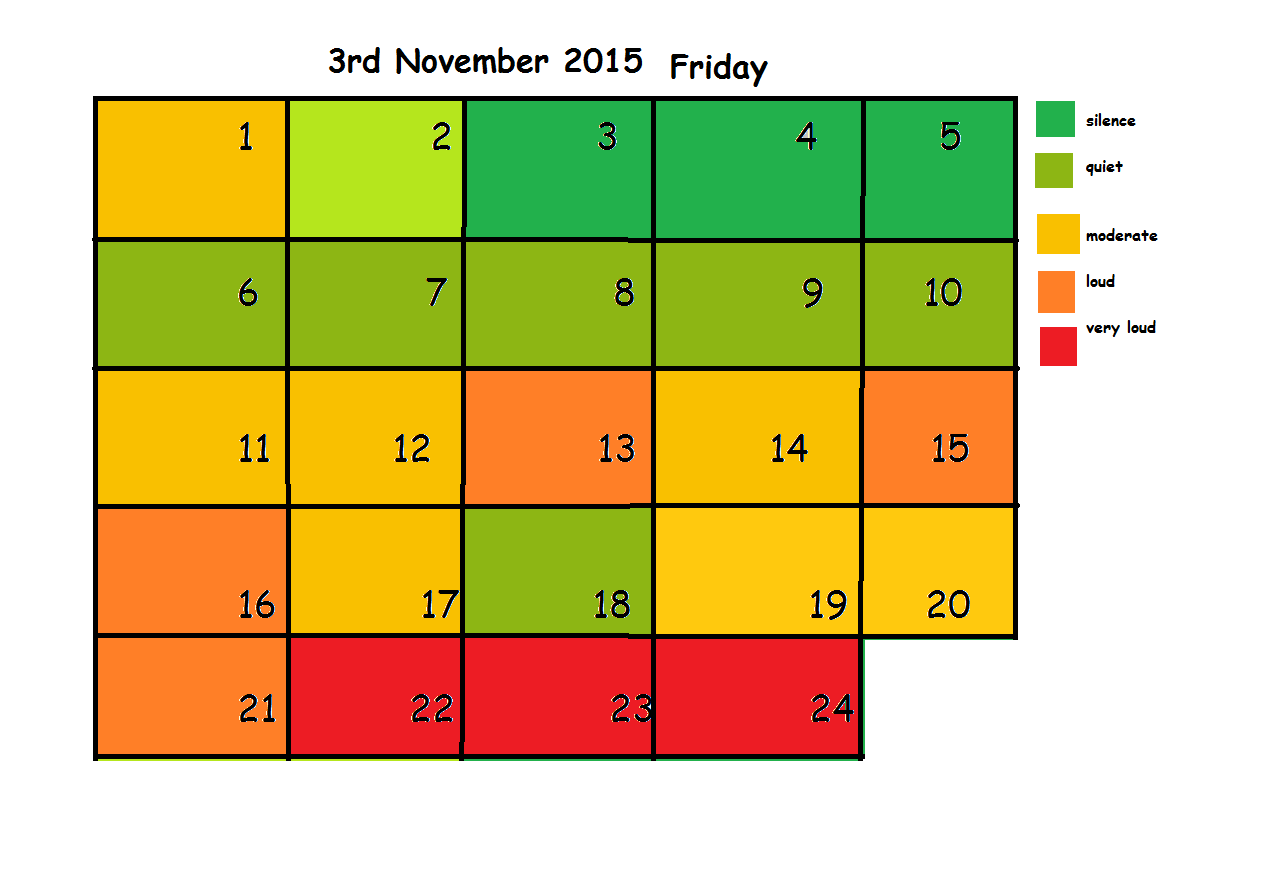
visualisation/Dan/Idea 2 - Calender/2.png
