Domoconnor/orange-corpus/Manufacture/clock/stl/clock_case2.stl

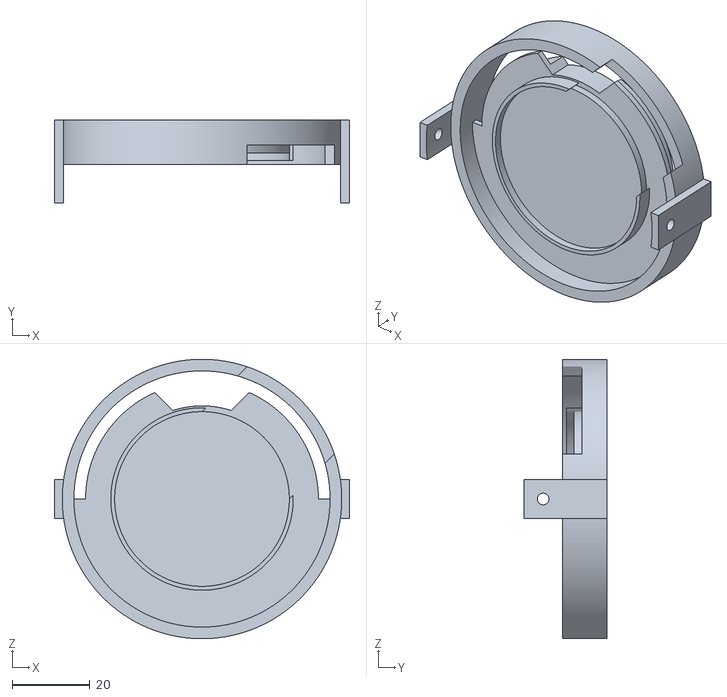
[picture p187: CAD file, 2016-03-31]
Manufacture/clock/stl/clock_case2.stl
76.0 x 21.5 x 72.0
