Domoconnor/orange-corpus/Manufacture/hub/frdm_hub/base/stl/hubTest1_1.stl

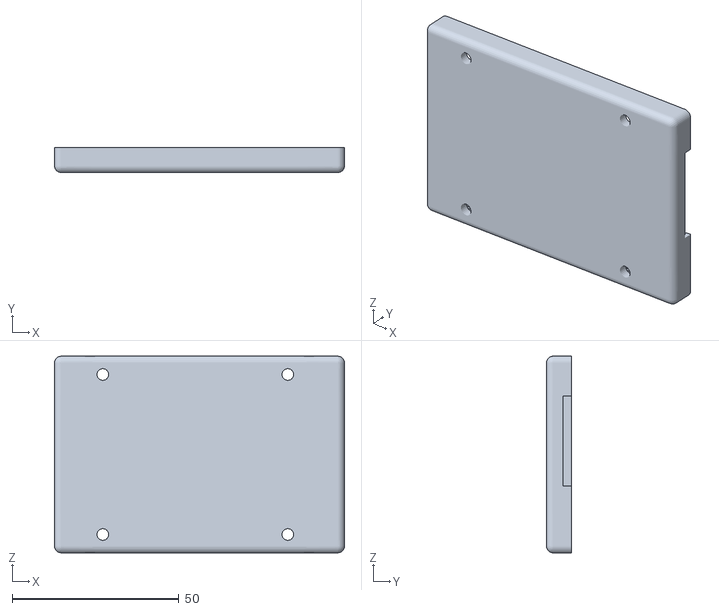
[picture p188: CAD file, 2016-03-31]
Manufacture/hub/frdm_hub/base/stl/hubTest1_1.stl
87.0 x 7.50 x 59.0
