Domoconnor/orange-corpus/Manufacture/hub/frdm_hub/lid/STLs/HUB_LID_IT1.stl

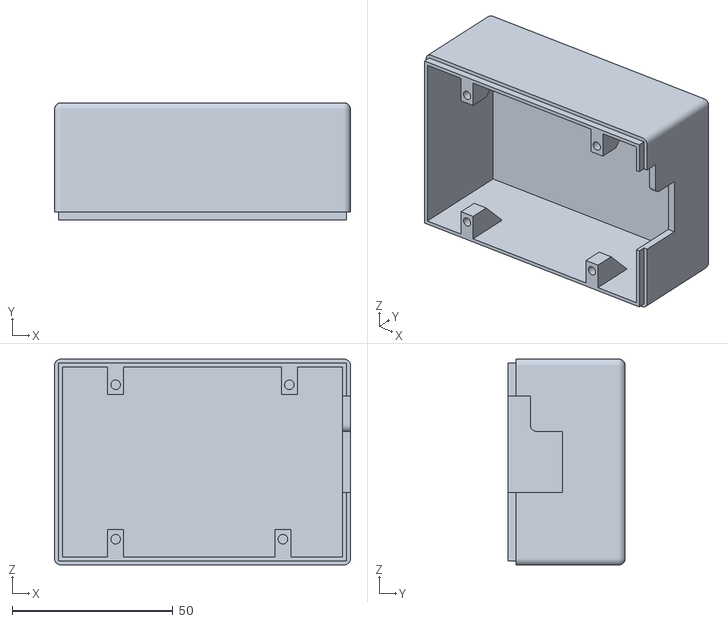
[picture p189: CAD file, 2016-03-31]
Manufacture/hub/frdm_hub/lid/STLs/HUB_LID_IT1.stl
92.0 x 36.5 x 64.0
