Domoconnor/orange-corpus/Manufacture/hub/pi_hub/stl/bottom1.stl

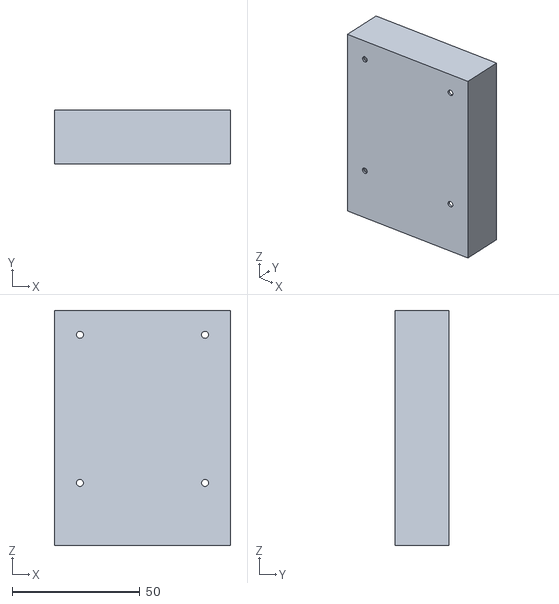
[picture p190: CAD file, 2016-03-31]
Manufacture/hub/pi_hub/stl/bottom1.stl
69.0 x 21.0 x 92.0
