Domoconnor/orange-corpus/Manufacture/sensor/sensor_V2/stl/sensor_V2_top_1.stl

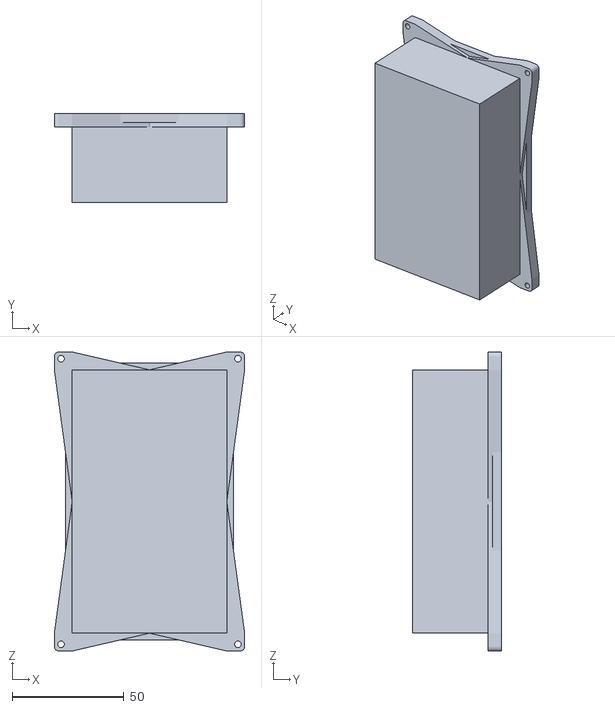
[picture p191: CAD file, 2016-03-31]
Manufacture/sensor/sensor_V2/stl/sensor_V2_top_1.stl
85.3 x 40.0 x 134.1
