Domoconnor/orange-corpus/Manufacture/sensor/waterproofing/stl/waterproofing1.stl

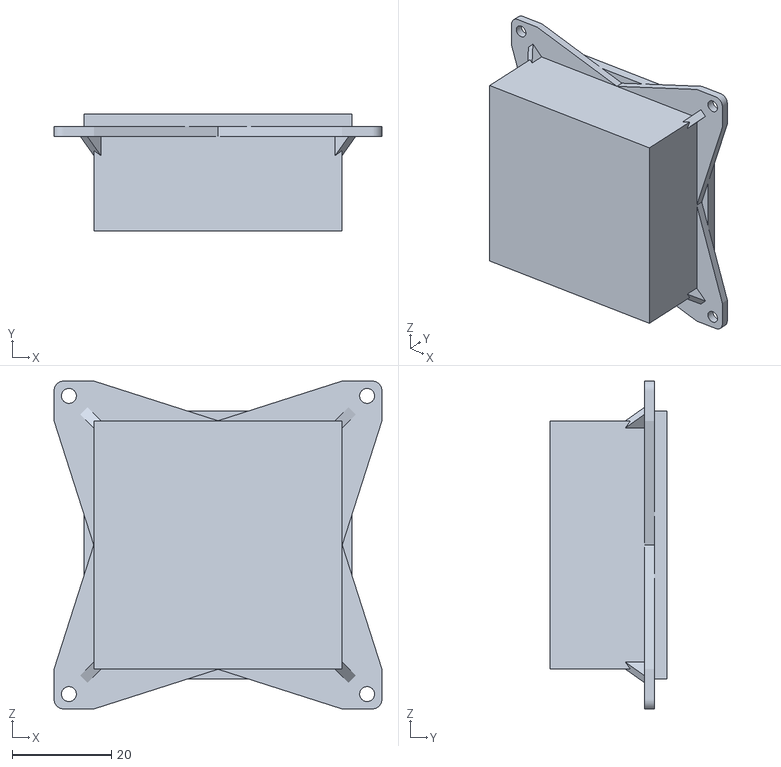
[picture p192: CAD file, 2016-03-31]
Manufacture/sensor/waterproofing/stl/waterproofing1.stl
66.0 x 23.5 x 66.0
