Domoconnor/orange-corpus/Manufacture/clock/fixing2.dxf

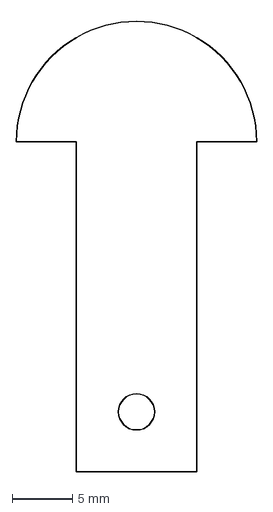
[picture p193: CAD file, 2016-03-31]
Manufacture/clock/fixing2.dxf
20.0 x 38.0 mm
