Domoconnor/orange-corpus/Manufacture/hub/frdm_hub/base/stl/hubTest1_2.stl

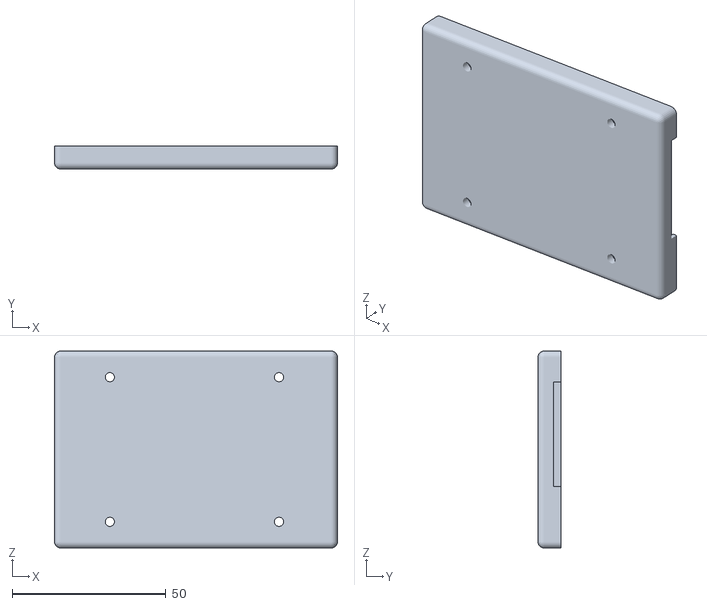
[picture p194: CAD file, 2016-03-31]
Manufacture/hub/frdm_hub/base/stl/hubTest1_2.stl
92.0 x 7.50 x 64.0
