Domoconnor/orange-corpus/Manufacture/hub/pi_hub/stl/top1.stl

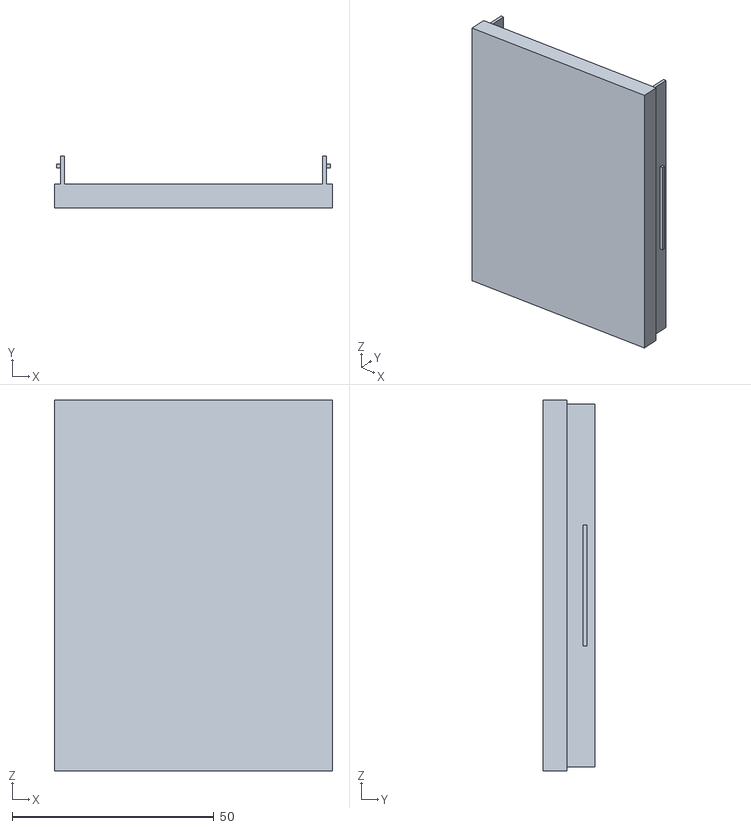
[picture p195: CAD file, 2016-03-31]
Manufacture/hub/pi_hub/stl/top1.stl
69.0 x 13.0 x 92.0
