Domoconnor/orange-corpus/Manufacture/sensor/sensor_V2/stl/sensor_V2_bottom.stl

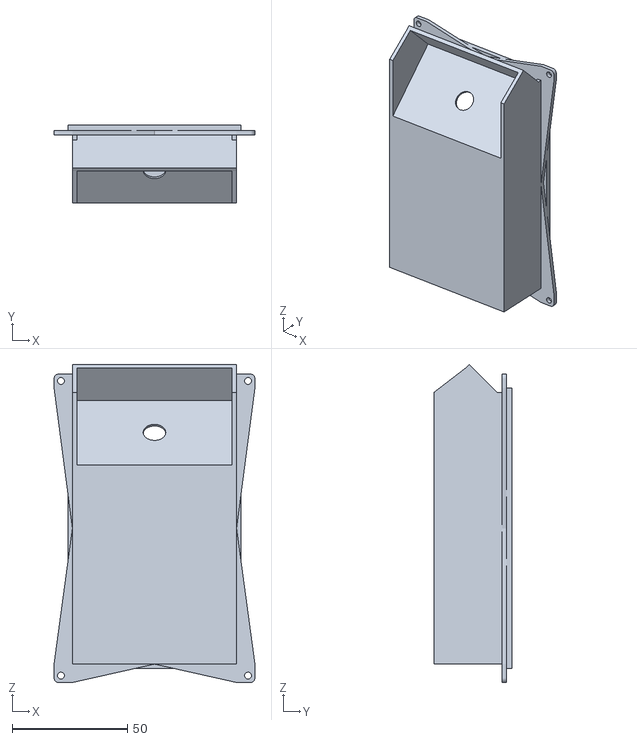
[picture p196: CAD file, 2016-03-31]
Manufacture/sensor/sensor_V2/stl/sensor_V2_bottom.stl
87.3 x 34.0 x 138.2
