Domoconnor/orange-corpus/Manufacture/sensor/waterproofing/stl/waterproofing2.stl

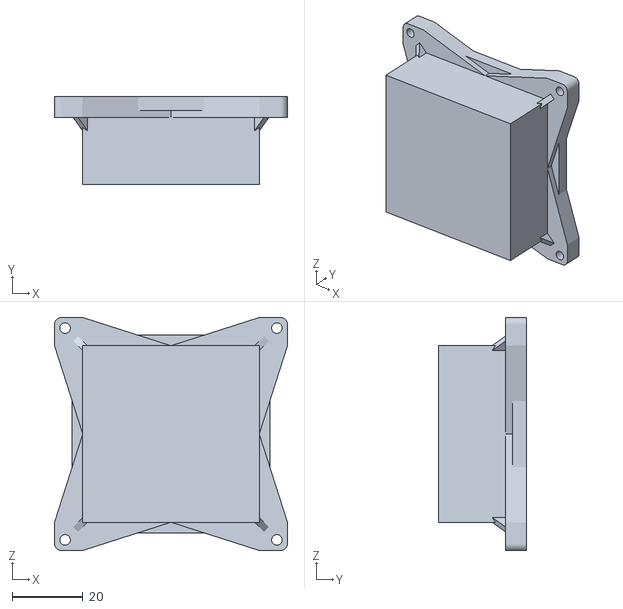
[picture p197: CAD file, 2016-03-31]
Manufacture/sensor/waterproofing/stl/waterproofing2.stl
66.0 x 25.0 x 66.0
