Domoconnor/orange-corpus/Manufacture/clock/clock_face.dxf

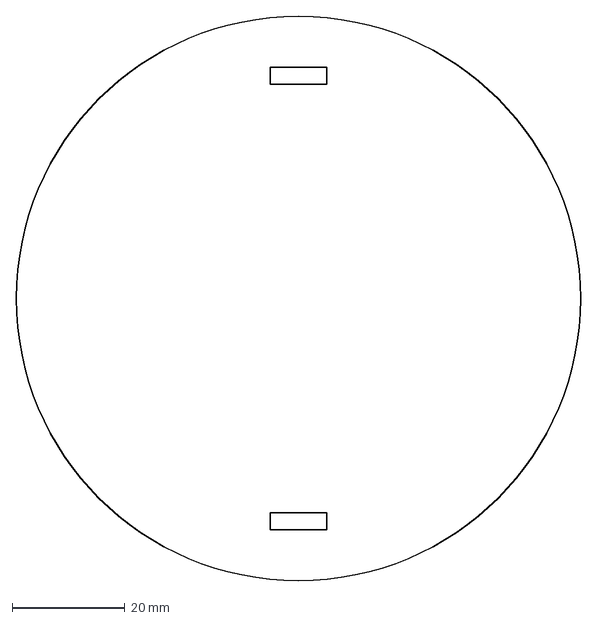
[picture p198: CAD file, 2016-03-31]
Manufacture/clock/clock_face.dxf
100.0 x 100.0 mm
