Domoconnor/orange-corpus/Manufacture/clock/stl/clock_case_bottom2_V2.stl

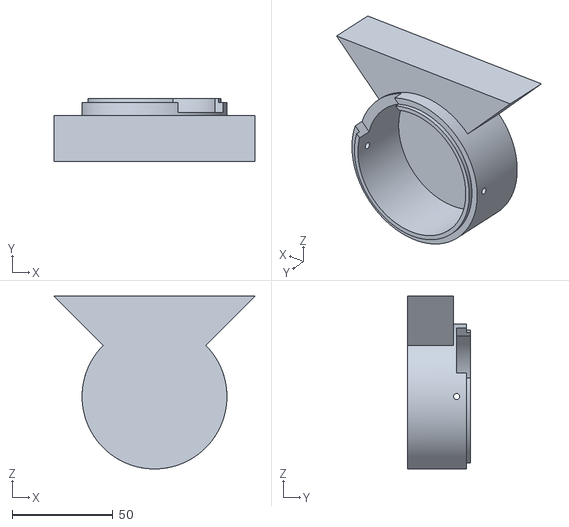
[picture p199: CAD file, 2016-03-31]
Manufacture/clock/stl/clock_case_bottom2_V2.stl
99.9 x 31.5 x 85.9
