Domoconnor/orange-corpus/Manufacture/hub/frdm_hub/base/stl/hubTest1.stl

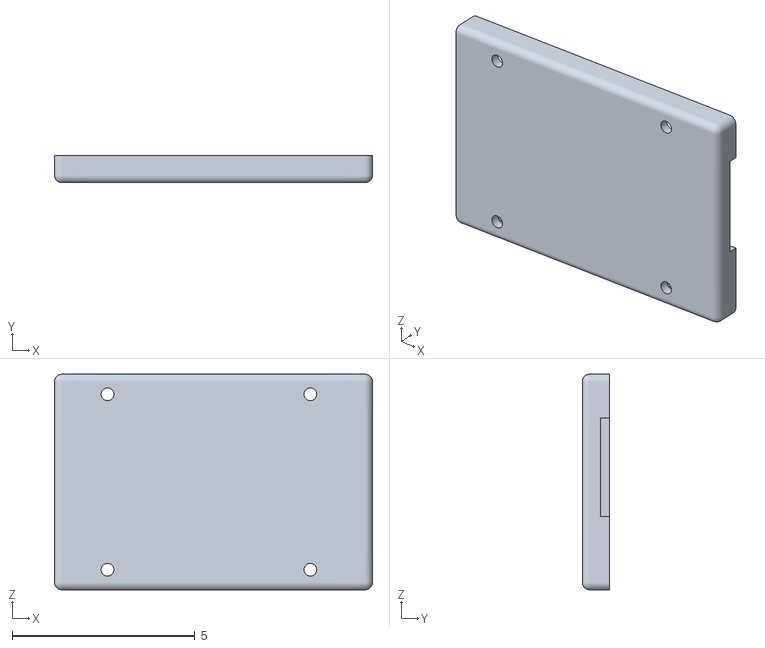
[picture p200: CAD file, 2016-03-31]
Manufacture/hub/frdm_hub/base/stl/hubTest1.stl
8.70 x 0.75 x 5.90
