Domoconnor/orange-corpus/Manufacture/sensor/sensor_V2/stl/sensor_V2_top_2.stl

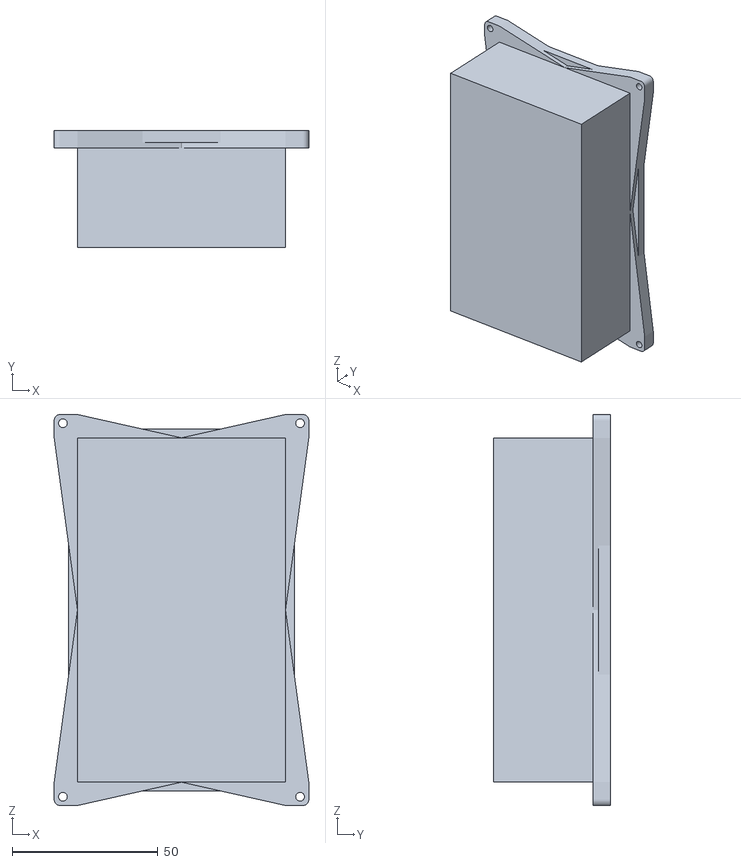
[picture p201: CAD file, 2016-03-31]
Manufacture/sensor/sensor_V2/stl/sensor_V2_top_2.stl
87.3 x 40.0 x 134.1
