Domoconnor/orange-corpus/Manufacture/clock/fixing.dxf

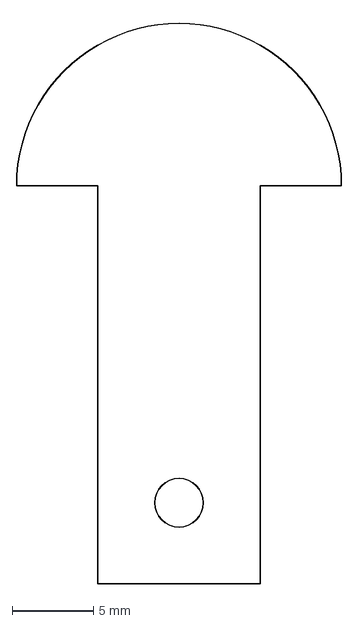
[picture p202: CAD file, 2016-03-31]
Manufacture/clock/fixing.dxf
20.0 x 35.0 mm
