Domoconnor/orange-corpus/Manufacture/sensor/sensor_V2/stl/boardtable.stl

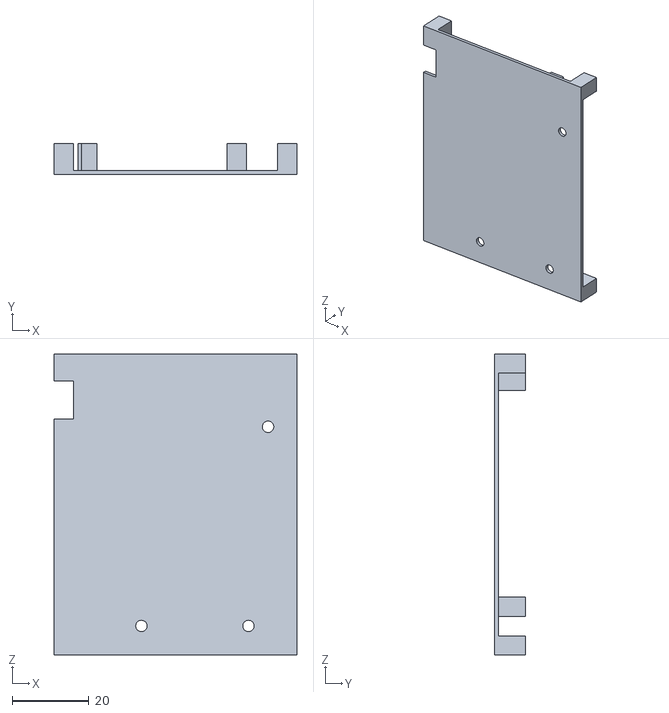
[picture p203: CAD file, 2016-03-31]
Manufacture/sensor/sensor_V2/stl/boardtable.stl
63.3 x 8.00 x 78.6
