Domoconnor/orange-corpus/(list of files, cad)

Other CAD files:
Manufacture/clock/face.dwg
Manufacture/hub/frdm_hub/base/stl/hubtest1_3.stl
Manufacture/clock/clock_case.ipt
Manufacture/clock/clock_case2.ipt
Manufacture/clock/clock_case_bottom_V1.ipt
Manufacture/clock/face.ipt
Manufacture/clock/fixing.ipt
Manufacture/hub/frdm_hub/base/hubtest1_2.ipt
Manufacture/hub/frdm_hub/base/hubtest1_3.ipt
Manufacture/hub/frdm_hub/base/hubtest1_4.ipt
Manufacture/hub/frdm_hub/lid/HUB_LID_IT1.ipt
Manufacture/hub/frdm_hub/lid/HUB_LID_IT2.ipt
Manufacture/hub/pi_hub/bottom1.ipt
Manufacture/hub/pi_hub/bottom2.ipt
Manufacture/hub/pi_hub/top1.ipt
Manufacture/hub/pi_hub/top2.ipt
Manufacture/sensor/sensor_V1/micGauge.ipt
Manufacture/sensor/sensor_V1/sensor_V1_mic.ipt
Manufacture/sensor/sensor_V1/sensor_V1_mic_2.ipt
Manufacture/sensor/sensor_V1/sensor_V1_usb.ipt
Manufacture/sensor/sensor_V1/sensor_V1_usb_2.ipt
Manufacture/sensor/sensor_V1/stl/micGauge.stl
Manufacture/sensor/sensor_V1/stl/sensor_V1_mic.stl
Manufacture/sensor/sensor_V1/stl/sensor_V1_mic_2.stl
Manufacture/sensor/sensor_V1/stl/sensor_V1_usb.stl
Manufacture/sensor/sensor_V1/stl/sensor_V1_usb_2.stl
Manufacture/sensor/sensor_V2/boardtable.ipt
Manufacture/sensor/sensor_V2/boardtable_V2.ipt
Manufacture/sensor/sensor_V2/sensor_V2_bottom.ipt
Manufacture/sensor/sensor_V2/sensor_V2_top_1.ipt
Manufacture/sensor/sensor_V2/sensor_V2_top_2.ipt
Manufacture/sensor/waterproofing/waterproofing1.ipt
Manufacture/sensor/waterproofing/waterproofing2.ipt
