Domoconnor/orange-corpus/(commit log)

2016-03-28 Update Hub.md
    Added better initial description of Hub, included 4 sections (Pi, XBee, Processing, Case
2016-03-28 Added files via upload
    Updated IMAGE 3 (Table of different wireless tech), removed 802.15.4
2016-03-28 Added files via upload
    Code from first iteration, used to sample the sound wave.
2016-03-30 Added files via upload
    Added sensor images for my iteration of the sensor
2016-03-30 Added files via upload
    Added code for the dummy sensor.
2016-03-30 Update sensor docs
2016-03-30 Add sensor code and make some changes to docs
2016-03-30 added a different networking and updated case
2016-03-30 updated case
2016-03-30 update contents and generate sample html
2016-03-30 Fixed sensor images
2016-03-30 Add data
    [cdata.csv]
2016-03-31 add circuit diagram
2016-03-31 case changes
    [HUB_LID_IT1.ipt, HUB_LID_IT1.stl, HUB_LID_IT2.ipt, boardtable.ipt, boardtable.stl, boardtable_V2.ipt, bottom1.ipt, bottom1.stl]
